eSpark-Backup/jordanfishman-telephonecircuit/Design-Files/TelephoneCircuit-v1.0/Deliverables/Renderings/2D-C-View.png

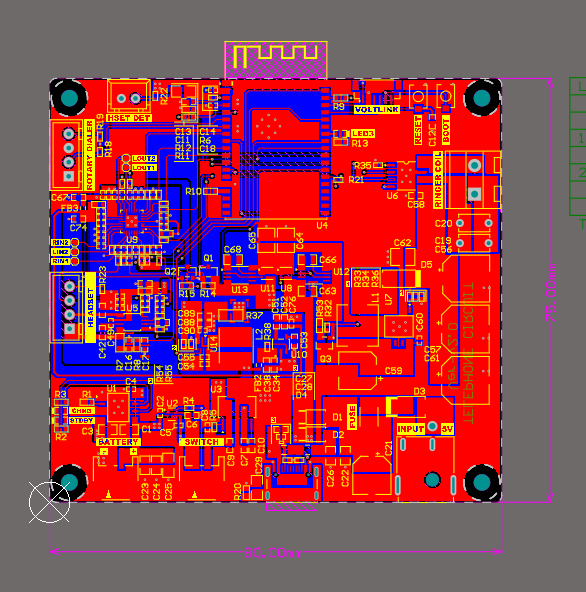
Design-Files/TelephoneCircuit-v1.0/Deliverables/Renderings/2D-C-View.png
