eSpark-Backup/jordanfishman-telephonecircuit/Design-Files/TelephoneCircuit-v1.0/Deliverables/Renderings/2D-TOP-View.png

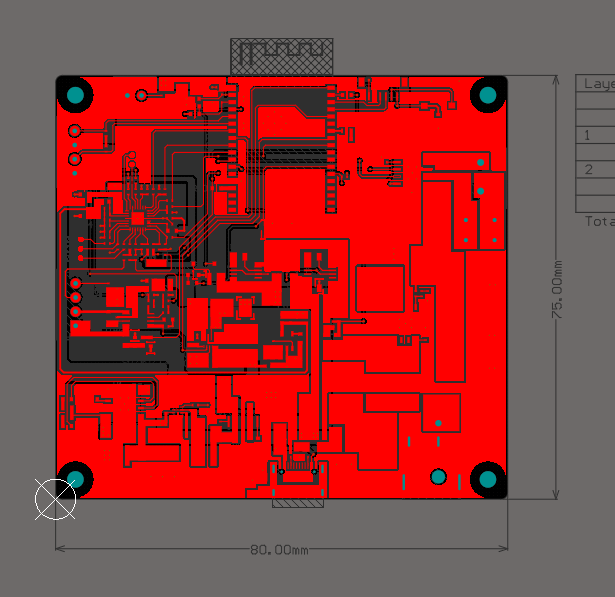
Design-Files/TelephoneCircuit-v1.0/Deliverables/Renderings/2D-TOP-View.png
