eSpark-Backup/jordanfishman-telephonecircuit/Design-Files/TelephoneCircuit-v1.0/Deliverables/Renderings/3D-BottomSide.png

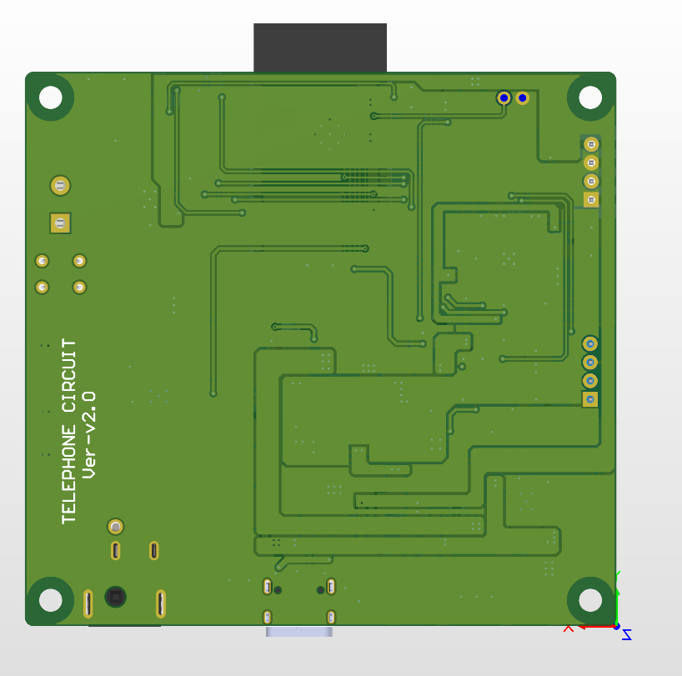
Design-Files/TelephoneCircuit-v1.0/Deliverables/Renderings/3D-BottomSide.png
