eSpark-Backup/jordanfishman-telephonecircuit/Design-Files/TelephoneCircuit-v1.0/Deliverables/Renderings/3D-TopSide.png

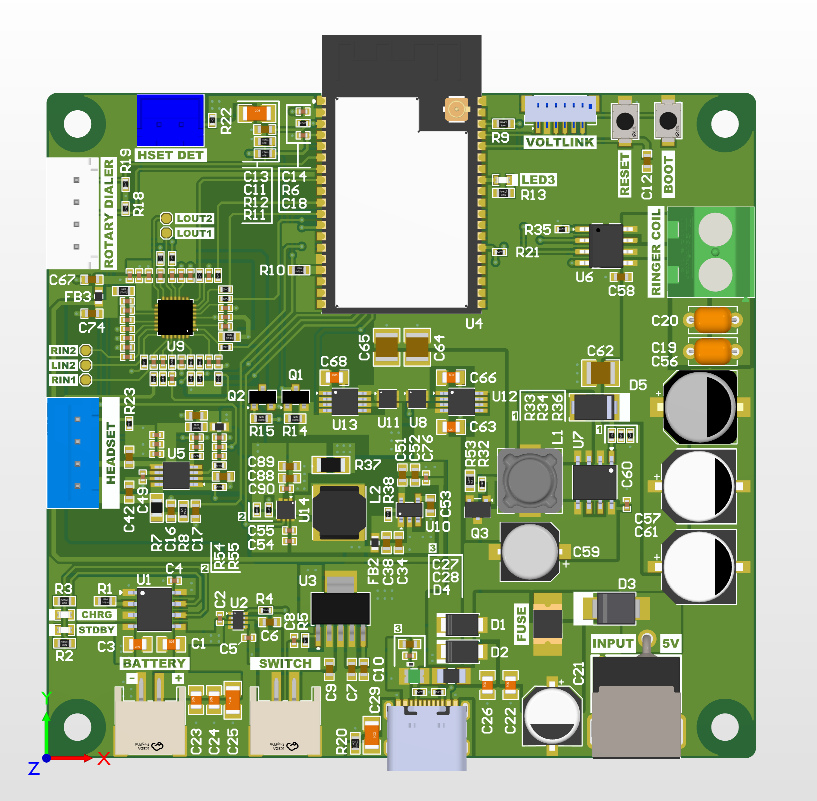
Design-Files/TelephoneCircuit-v1.0/Deliverables/Renderings/3D-TopSide.png
