eSpark-Backup/jordanfishman-telephonecircuit/Design-Files/TelephoneCircuit-v1.0/Deliverables/Renderings/Isometric.png

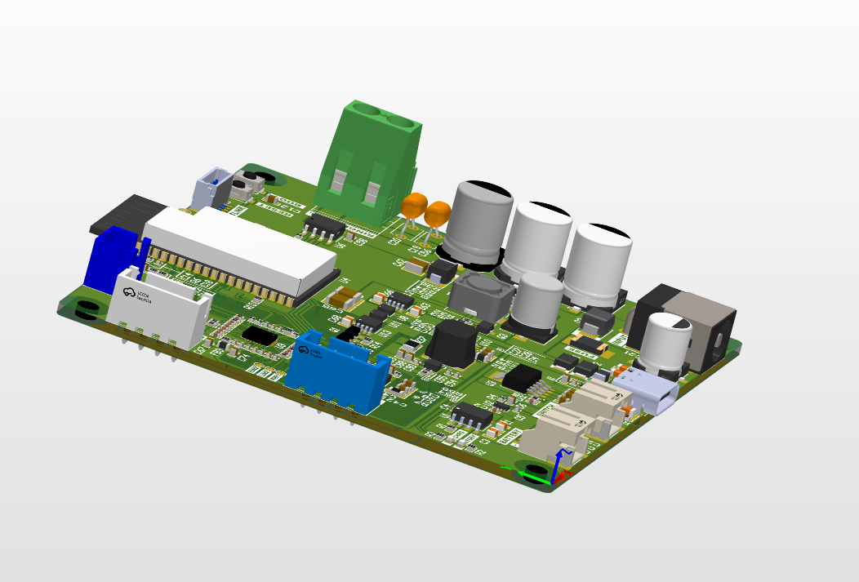
Design-Files/TelephoneCircuit-v1.0/Deliverables/Renderings/Isometric.png
