eSpark-Backup/jordanfishman-telephonecircuit/Design-Files/TelephoneCircuit-v1.0/Deliverables/BOM/Client-BOM-V1.0.xlsx

# | Item Type | Designator | Description | Footprint | Manufacturer Part Number | Manufacturer | Value | Quantity | Remarks
1 | Capacitor | C1, C3, C23, C24, C26 | CAP CER 10UF 25V X5R 0805 | Cap-0805 | CC0805KKX5R8BB106 | Yageo | 10uF | 5
2 | Capacitor | C2, C4, C5, C18, C30, C41, C44, C47, C55, C69, C70, C72, C75, C76, C83, C85, C87, C90 | CAP CER 0.1UF 25V X5R 0402 | Cap-0402 | CC0402KRX5R8BB104 | Yageo | 100nF | 18
3 | Capacitor | C6, C15, C50 | CAP CER 1UF 25V X5R 0603 | Cap-0603 | CC0603KRX5R8BB105 | Yageo | 1uF | 3
4 | Capacitor | C7, C88, C89 | CAP CER 22UF 10V X5R 0603 | Cap-0603 | CC0603MRX5R6BB226 | Yageo | 22uF | 3
5 | Capacitor | C8 | CAP CER 2.2UF 25V X5R 0402 | Cap-0402 | GRM155R61E225KE11D | Murata | 2.2uF | 1
6 | Capacitor | C9, C74 | CAP CER 10UF 16V X5R 0603 | Cap-0603 | CC0603KRX5R7BB106 | Yageo | 10uF | 2
7 | Capacitor | C10, C27 | CAP CER 10000PF 50V C0G/NPO 0603 | Cap-0603 | CC0603JRNPO9BN103 | Yageo | 10nF | 2
8 | Capacitor | C11 | CAP CER 1UF 50V X5R 0603 | Cap-0603 | CL10A105KB8NNNC | Samsung | 1uF | 1
9 | Capacitor | C12 | CAP CER 0.1UF 50V X5R 0603 | Cap-0603 | CC0603KRX5R9BB104 | Yageo | 100nF | 1
10 | Capacitors | C13, C25 | 10V 100uF X5R ±20% 1206 Multilayer Ceramic Capacitors MLCC - SMD/SMT ROHS | Cap-1206 | GRM31CR61A107ME05L | Murata | 100uF | 2
11 | Capacitors | C14 | CAP CER 0.1UF 16V X5R 0402 | Cap-0402 | CC0402KRX5R7BB104 | Yageo | 100nF | 1
12 | Capacitor | C16, C17 | 25V 100nF X7R ±10% 0603 Multilayer Ceramic Capacitors MLCC - SMD/SMT ROHS | Cap-0603 | CL10B104KA8NNNC | Samsung Electro-Mechanics | 100nF | 2
13 | Capacitor | C19 | 10% 100V 2.2uF X7R Plugin,P=5.08mm Multilayer Ceramic Capacitors MLCC - Leaded ROHS | Custom | CD2A225KC9BER1F100 | Dersonic | 2.2uF | 1
14 | Capacitor | C20 | 10% 250V 1uF X7R Plugin,P=5.08mm Multilayer Ceramic Capacitors MLCC - Leaded ROHS | Custom | CD2E105KC1IER1I100 | Dersonic | 1uF | 1
15 | Capacitors | C21 | 220uF 35V 600mA@100KHz 160mΩ@100KHz ±20% SMD,D6.3xL7.7mm Aluminum Electrolytic Capacitors - SMD ROHS | Custom | 189RV0019 | KNSCHA | 220uF | 1
16 | Capacitors | C22 | CAP CER 1UF 100V X7S 0805 | Cap-0805 | GCM21BC72A105KE36L | Murata | 1uF | 1
17 | Capacitor | C28 | CAP CER 1UF 16V X5R 0402 | Cap-0402 | CC0402KRX5R7BB105 | Yageo | 1uF | 1
18 | Capacitor | C29 | CAP CER 4700PF 1KV X7R 1206 | Cap-1206 | CC1206KKX7RCBB472 | Yageo | 4.7nF | 1
19 | Capacitor | C31, C32, C46 | CAP CER 22UF 10V X5R 0402 | Cap-0402 | GRM158R61A226ME15D | Murata | 22uF | 3
20 | Capacitor | C33, C35, C54, C71, C73, C82, C84, C86 | CAP CER 10UF 10V X5R 0402 | Cap-0402 | CL05A106MP5NUNC | Samsung | 10uF | 8
21 | Capacitor | C34, C51 | CS Series 0603 0.1 uF 25 V ±10% X7R Multilayer Ceramic Capacitor | Cap-0603 | CS0603KRX7R8BB104 | Yageo | 0.1uF | 2
22 | Capacitor | C36, C37, C39, C40, C49 | CAP CER 1UF 16V X5R 0402 | Cap-0402 | CL05A105KO5NNNC | Samsung | 1uF | 5
23 | Capacitor | C38, C52 | CAP CER 10UF 25V X5R 0603 | Cap-0603 | CL10A106MA8NRNC | Samsung | 10uF | 2
24 | Capacitor | C42, C43 | CAP CER 330PF 50V C0G/NPO 0603 | Cap-0603 | CC0603JRNPO9BN331 | Yageo | 330pF | 2
25 | Capacitor | C45, C48 | CAP CER 39PF 50V C0G/NPO 0402 | Cap-0402 | CC0402FRNPO9BN390 | Yageo | 39pF | 2
26 | Capacitor | C53 | 25V 22nF X7R 0603 Multilayer Ceramic Capacitors MLCC - SMD/SMT ROHS | Cap-0603 | FN18X223K250PSG | PSA(Prosperity Dielectrics) | 22nF | 1
27 | Capacitor | C56 | CAP ALUM 47UF 20% 80V SMD | Custom | EEE-FN1K470UP | Panasonic | 47uF | 1
28 | Capacitor | C57, C61 | 100uF 80V 735mA@100kHz ±20% SMD,D8xL14.5mm Aluminum Electrolytic Capacitors - SMD ROHS | Custom | VKMD1451K101MV | Ymin | 100uF | 2
29 | Capacitor | C58 | CAP CER 0.1UF 50V Y5V 0603 | Cap-0603 | CC0603ZRY5V9BB104 | Yageo | 0.1uF | 1
30 | Capacitor | C59 | 330uF 16V ±20% SMD,D6.3xL7.7mm Aluminum Electrolytic Capacitors - SMD ROHS | Custom | GVT1C331M0607 | Honor Elec | 330uF | 1
31 | Capacitor | C60 | CAP CER 4.7UF 10V X5R 0402 | Cap-0402 | CC0402KRX5R6BB475 | Yageo | 4.7uF | 1
32 | Capacitor | C62, C64, C65 | CAP CER 10UF 63V X7R 1210 | Cap-1210 | GRM32ER71J106KA12L | Murata | 10uF | 3
33 | Capacitor | C63 | CAP CER 100PF 50V X7R 0805 | Cap-0805 | CC0805KRX7R9BB101 | Yageo | 100pF | 1
34 | Capacitor | C66, C68 | CAP CER 2.2UF 50V X5R 0805 | Cap-0805 | C2012X5R1H225K125AB | TDK | 2.2uF | 2
35 | Capacitor | C67 | CAP CER 4.7UF 16V X5R 0603 | Cap-0603 | CC0603KRX5R7BB475 | Yageo | 4.7uF | 1
36 | Capacitor | C77, C78, C79, C80, C81 | CAP CER 20PF 50V C0G/NPO 0402 | Cap-0402 | CC0402JRNPO9BN200 | Yageo | 20pF | 5
37 | Diodes | D1, D2 | DIODE SCHOTTKY 30V 3A SOD128 | SOD-128 | PMEG3030EP,115 | Nexperia | - | 2
38 | Diode | D3 | SCHOTTKY DIODE SMB 100V 5A | SMB_ | SS510B | MDD | - | 1
39 | Diode | D4 | TVS DIODE 5VWM 6.3VC DSN0603-2 | DSN0603-2 | PESD5V0H1BSFYL | Nexperia | - | 1
40 | Diode | D5 | 60V 700mV@2A 2A SMA(DO-214AC) Schottky Barrier Diodes (SBD) ROHS | SMA(DO-214AC) | SS26 | MDD | - | 1
41 | Fuse | F1 | 13.2V 2.6A 40A 800mW -40℃~+85℃ 5.2A 10mΩ 2.5s 50mΩ 1812 Resettable Fuses ROHS | 1812-FUSE | BSMD1812-260-13.2V | BHFUSE | - | 1
42 | Fuse | F2 | 6V 2A 50A 1W -40℃~+85℃ 4A 4mΩ 5s 45mΩ 0805 Resettable Fuses ROHS | Fuse-0805 | BSMD0805L-200 | BHFUSE | - | 1
43 | Ferrite Bead | FB1 | FERRITE BEAD 120 OHM 1206 1LN | IND-1206 | BLM31PG121SN1L | Murata | 100MHz | 1
44 | Ferrite Bead | FB2, FB3 | FERRITE BEAD 120 OHM 0603 1LN | IND-0603 (1608 Metric) | BLM18SG121TN1D | Murata | - | 2
45 | Ferrite Bead | FB4 | 0603 180Ω ±25% DCR=0.09Ω 1.5A | IND-0603 (1608 Metric) | BLM18PG181SN1D | Murata | - | 1
46 | Connectors | J1, J3 | CONN HEADER SMD R/A 2POS 2MM | Custom | S2B-PH-SM4-TB(LF)(SN) | JST | - | 2
47 | Connector | J2 | 1x6P SH 1 1mm 6 SMD,P=1mm Wire To Board / Wire To Wire Connector ROHS | Custom | C145963 | BOOMELE | - | 1
48 | DC Power Connectors | J4 | Bend insert DC Power Receptacle -30℃~+85℃ 2.5mm 6mm 7A 24V Plugin DC Power Connectors ROHS | Custom | DC-044K-D025 | G-Switch | - | 1
49 | Terminal Blocks | J5 | TERM BLK 2P SIDE ENT 5.08MM PCB | Custom | 1715721 | Phoenix Contact | - | 1
50 | USB Connector | J6 | 5A 1 16P Female Type-C SMD USB Connectors ROHS | Custom | TYPE-C-31-M-12 | Korean Hroparts Elec | - | 1
51 | Wire To Board Connector | J7 | 1x4P 4P XH 1 Tin 2.5mm 4 -25℃~+85℃ Brass 3A Straight Plugin,P=2.5mm Wire To Board Connector ROHS | Custom | XH-4A | HCTL | - | 1
52 | Wire To Board Connector | J8 | 1x2P 2P XH 1 Tin 2.5mm 2 -25℃~+85℃ Brass 3A Straight Plugin,P=2.5mm Wire To Board Connector ROHS | Custom | XH-2A-L | HCTL | - | 1
53 | Wire To Board Connector | J9 | 1x4P 4P XH 1 Tin 2.5mm 4 -25℃~+85℃ Brass 3A Straight Plugin,P=2.5mm Wire To Board Connector ROHS | Custom | XH-4A-L | HCTL | - | 1
54 | Inductor | L1 | 3.7A 4.7uH ±20% SMD,7.3x7.3mm Power Inductors ROHS | Custom | YPRH0704-4R7M | YJYCOIN | 4.7uH | 1
55 | INductor | L2 | 5.15A 1uH ±30% SMD Power Inductors ROHS | Custom | MPIT6045-1R0N-LF | microgate | 1uH | 1
56 | LED | LED1, LED3 | RED LED 0603 Light Emitting Diodes | LED-0603 | NCD0603R3 | Foshan NationStar Optoelectronics | - | 2
57 | LED | LED2 | Emerald 0603 Light Emitting Diodes (LED) ROHS | LED-0603 | NCD0603G2 | Foshan NationStar Optoelectronics | - | 1
58 | Mosfet | Q1 | 30V 4.1A 60mΩ@10V,4.1A 350mW 3V@250uA P Channel SOT-23 MOSFETs ROHS | SOT-23 | AO3407 | Guangdong Hottech | - | 1
59 | Mosfet | Q2 | TRANS NPN 40V 0.6A SMD SOT23-3 | SOT-23 | MMBT2222A-7-F | Diodes | - | 1
60 | MOSFETs | Q3 | MOSFET P-CH 20V 6A SOT23F | SOT-23F | SSM3J328R,LF | Toshiba | - | 1
61 | Resistor | R1 | Thick Film Resistors 75V 1.2kΩ 0603 Chip Resistor - Surface Mount ROHS | Res-0603 | 0603WAF1201T5E | UNI-ROYAL | 1.2K | 1
62 | Resistor | R2, R3 | RES SMD 330R 100 mW 0603 | Res-0603 | RC0603JR-07330RL | Yageo | 330R | 2
63 | Resistor | R4, R5, R32, R45 | RES 10K OHM 1% 1/16W 0402 | Res-0402 | RC0402FR-0710KL | Yageo | 10K | 4
64 | Resistor | R6, R18, R19, R22, R51 | RES 10K OHM 1% 1/5W 0402 | Res-0402 | SR0402FR-7T10KL | Yageo | 10K | 5
65 | Resistor | R7 | RES 10K OHM 1% 1/4W 0805 | RES-0805 | RC0805FR-7W10KL | Yageo | 10K | 1
66 | Resistor | R8, R9, R10 | RES SMD 1K OHM 1% 1/10W 0603 | Res-0603 | CRCW06031K00FKEA | Vishay Dale | 1K | 3
67 | Resistor | R11 | RES SMD 100K OHM 0.1% 1/10W 0603 | Res-0603 | RT0603BRD07100KL | Yageo | 100K | 1
68 | Resistor | R12 | RES 270K OHM 0.5% 1/10W 0603 | Res-0603 | RC0603DR-07270KL | Yageo | 270K | 1
69 | Resistors | R13 | RES SMD 100 OHM 1% 1/10W 0603 | Res-0603 | CRCW0603100RFKEA | Vishay Dale | 100R | 1
70 | Resistor | R14, R15 | RES SMD 1K OHM 1% 1/10W 0603 | Res-0603 | RC0603FR-071KL | Yageo | 1K | 2
71 | Resistor | R16, R17 | RES 5.1K OHM 1% 1/16W 0402 | Res-0402 | RC0402FR-075K1L | Yageo | 5.1K | 2
72 | Resistor | R20 | RES SMD 1M OHM 1% 1/10W 0603 | Res-0603 | RC0603FR-071ML | Yageo | 1M | 1
73 | Resistor | R21, R23, R30 | RES SMD 0 OHM JUMPER 1/5W 0402 | Res-0402 | RCS04020000Z0ED | Vishay Dale | 0R | 3
74 | Resistor | R24, R25, R46, R47, R48, R49, R50 | RES 33 OHM 1% 1/16W 0402 | Res-0402 | RC0402FR-0733RL | Yageo | 33R | 7
75 | Resistor | R26 | RES SMD 10 OHM 1% 1/10W 0603 | Res-0603 | RC0603FR-0710RL | Yageo | 10R | 1
76 | Resistor | R27, R31 | RES SMD 30K OHM 1% 1/16W 0402 | Res-0402 | AC0402FR-0730KL | Yageo | 30K | 2
77 | Resistor | R28, R38 | RES 1K OHM 1% 1/16W 0402 | Res-0402 | RC0402FR-071KL | Yageo | 1K | 2
78 | Resistor | R29, R41, R43 | RES 2K OHM 1% 1/16W 0402 | Res-0402 | RC0402FR-072KL | Yageo | 2K | 3
79 | Resistor | R33 | RES SMD 240K OHM 1% 1/10W 0402 | Res-0402 | ERJ-2RKF2403X | Panasonic | 240K | 1
80 | Resistor | R34 | RES 6.2K OHM 1% 1/16W 0402 | Res-0402 | RC0402FR-076K2L | Yageo | 6.2K | 1
81 | Resistor | R35 | RES SMD 1.3K OHM 5% 1/10W 0402 | Res-0402 | ERJ-2GEJ132X | Panasonic | 1.3K | 1
82 | Resistor | R36 | 62.5mW Thick Film Resistors 50V ±100ppm/℃ ±0.5% 806Ω 0402 Chip Resistor - Surface Mount ROHS | Res-0402 | 0402WGD8060TCE | UNI-ROYAL | 806R | 1
83 | Resistor | R37 | RES SMD 0 OHM JUMPER 1/4W 1206 | Res-1206 | CRCW12060000Z0EA | Vishay | 0R | 1
84 | Resistor | R39 | RES SMD 47OHM 0.1W 0603 | Res-0603 | RC0603FR-0747RL | Yageo | 47R | 1
85 | Resistor | R40 | RES 4.7 OHM 1% 1/10W 0603 | Res-0603 | RC0603FR-074R7L | Yageo | 4.7R | 1
86 | Resistor | R42, R44 | RES 100 OHM 1% 1/16W 0402 | Res-0402 | RC0402FR-07100RL | Yageo | 100R | 2
87 | Resistor | R52, R55 | RES 100K OHM 1% 1/16W 0402 | Res-0402 | RC0402FR-07100KL | Yageo | 100K | 2
88 | Resistor | R53 | RES 0 OHM JUMPER 1/10W 0603 | Res-0603 | RC0603JR-070RL | Yageo | 0R | 1
89 | Resistor | R54 | 62.5mW Thick Film Resistors ±1% ±200ppm/℃ 732kΩ 0402 Chip Resistor - Surface Mount ROHS | Res-0402 | RC-02W7323FT | FH (Guangdong Fenghua Advanced Tech) | 732K | 1
90 | Tactile Switch | SW1, SW2 | Without bracket 50mA 4mm 100000 Times 12V 160gf 3mm 2mm Round Button Standing paste SPST SMD Tactile Switches ROHS | Custom | TS-1088-AR02016 | XUNPU | - | 2
91 | IC | U1 | ESOP-8 Battery Management ICs ROHS | ESOP-8 | TP4056-42-ESOP8 | TOPPOWER | - | 1
92 | IC | U2 | OR Controller N+1 ORing Controller N-Channel 2:1 SOT-583 | SOT-583 | LM66200DRLR | Texas Instruments | - | 1
93 | IC | U3 | IC REG LINEAR 3.3V 1A SOT223-6 | SOT-223-6_ | TPS79633DCQR | Texas Instruments | - | 1
94 | Module | U4 | RF TXRX MODULE BT PCB TRACE SMD | Custom | ESP32-WROVER-E-N16R8 | Espressif Systems | - | 1
95 | IC | U5 | 3Wx1@4Ω Class D MSOP-8 Audio Power OpAmps ROHS | 8-MSOP (0.118", 3.00mm Width) | NS4150B | Shenzhen Nsiway Tech | - | 1
96 | IC | U6 | 48-V, 3.5-A H BRIDGE MOTOR DRIVE | SOPowerPAD(DDA)-8 | DRV8251ADDAR | Texas Instruments | - | 1
97 | IC | U7 | Boost type Adjustable 500mA 3V~60V 3V~60V ESOP-8 DC-DC Converters ROHS | ESOP-8 | LGS6302EP | Legend-Si | - | 1
98 | IC | U8, U11 | 30V 5A 2.3W 30mΩ@4A,8V null WSON-6 MOSFETs ROHS | Custom | CSD17313Q2 | Texas Instruments | - | 2
99 | IC | U9 | QFN-28-EP(4x4) ADCs/DACs - Special Purpose ROHS | QFN-28-EP(4x4) | ES8388 | Everest-semi | - | 1
100 |  | U10 | IC REG LDO 3.3V 0.3A SOT23-5 | SOT-23-5 | RT9193-33GB | Richtek | - | 1
101 | IC | U12, U13 | IC SMART DIODE CTLR 8VSSOP | 8-VSSOP (5x3.1mm) | LM74610QDGKRQ1 | Texas Instruments | - | 2
102 | IC | U14 | 8-A boost converter with 0.5-V ultra-low input voltage 7-VQFN-HR -40 to 125 | 7-VQFN-HR (2x2) | TPS61022RWUR | Texas Instruments | - | 1
103 | Peripheral | - | 16mm Flat Head Locking Panel Mount Push Button | - | 16mm Metal Button | - |  | 1 | Aliexpress (https://vi.aliexpress.com/item/1005005545806818.html?gatewayAdapt=glo2vnm)
104 | Peripheral | - | 20CM JST PH 2.0 2.0mm Pitch 2 Pin Male Female Cable Connector Micro JST PH 2P Plug Jack Socket Terminals Wire Cables Connectors | - | JST Cable | - | - | 1 | Aliexpress (https://vi.aliexpress.com/item/1005003235174686.html)
105 | Peripheral | - | 5V US 2Amp 5.5*2.5mm DC Power adapter | - | Adaptor | - | - | 1 | Aliexpress (https://vi.aliexpress.com/item/1005005815301733.html?scm_id=1007.40196.366991.0&scm-url=1007.40196.366991.0)
