eSpark-Backup/jordanfishman-telephonecircuit/Design-Files/TelephoneCircuit-v1.0/Deliverables/Supporting Files/Telephone Circuit v1.0.step

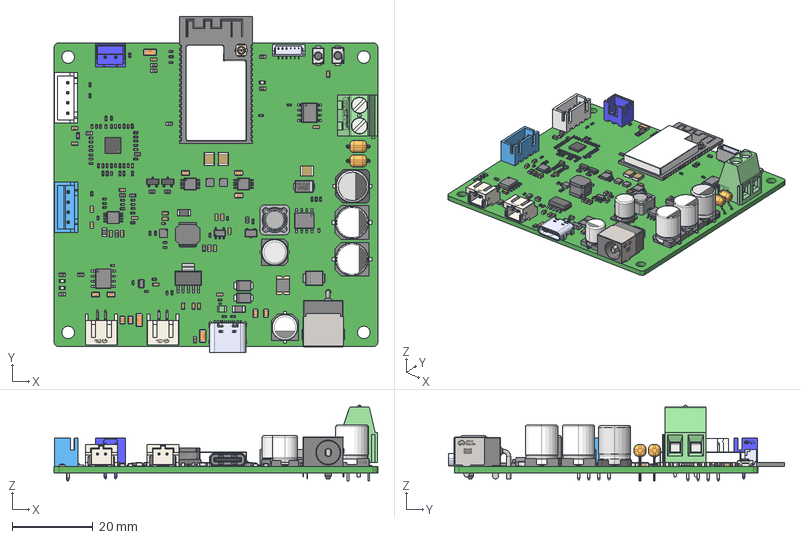
[picture p7: CAD file, 2025-02-03]
Design-Files/TelephoneCircuit-v1.0/Deliverables/Supporting Files/Telephone Circuit v1.0.step
80.0 x 83.0 x 18.7 mm
User Library-CAPC1608X09 x 23
TPS61022RWUR--3DModel-STEP-56544
LM74610QDGKRQ1 x 2
CSD17313Q2--3DModel-STEP-231308 x 2
SN74LV1T34DBVR
ES8374
TP4056-42-ESOP8--3DModel-STEP-56544 x 2
AD8223BRMZ-R7
ESP32-WROVER-I--3DModel-STEP-56544
User Library-SOT-223-6
User Library-RES_1005-0402 x 37
User Library-RESC1608X05N x 16
User Library-CR3216-1206
User Library-CR2012-0805
SSM3K333R_LF
CircuitWorks-SOT-23 x 2
User Library-LED SMD0603 x 3
MPIT6045-1R0N-LF
YPRH0704-4R7M
TYPE-C-31-M-12
SOLID.step.STEP.dwg.STEP.STEP.dwg
Lötende x 6
base x 3
BLM31PG121SN1L
User Library-fuse0805L050WR
MF-MSMF050
SMA (DO-214AC)
PESD5V0H1BSF
User Library-DO-214AA SMB
User Library-Capacitor 0402 x 45
User Library-0805 SMD Capacitor x 9
User Library-CAPC3225X10 x 3
VKMD1451K101MV x 2
GVT1C331M0607
User Library-1206 SMD Capacitor x 3
