eSpark-Backup/jordanfishman-telephonecircuit/(list of files, cad)

Other CAD files:
Design-Files/TelephoneCircuit-v1.0/Deliverables/Supporting Files/Telephone Circuit v1.0.DWG
Design-Files/TelephoneCircuit-v1.0/Deliverables/Supporting Files/Telephone Circuit v1.0.DXF
