eSpark-Backup/jordanfishman-telephonecircuit/Design-Files/TelephoneCircuit-v1.0/Schematic/Telephone Circuit V1.0.pdf

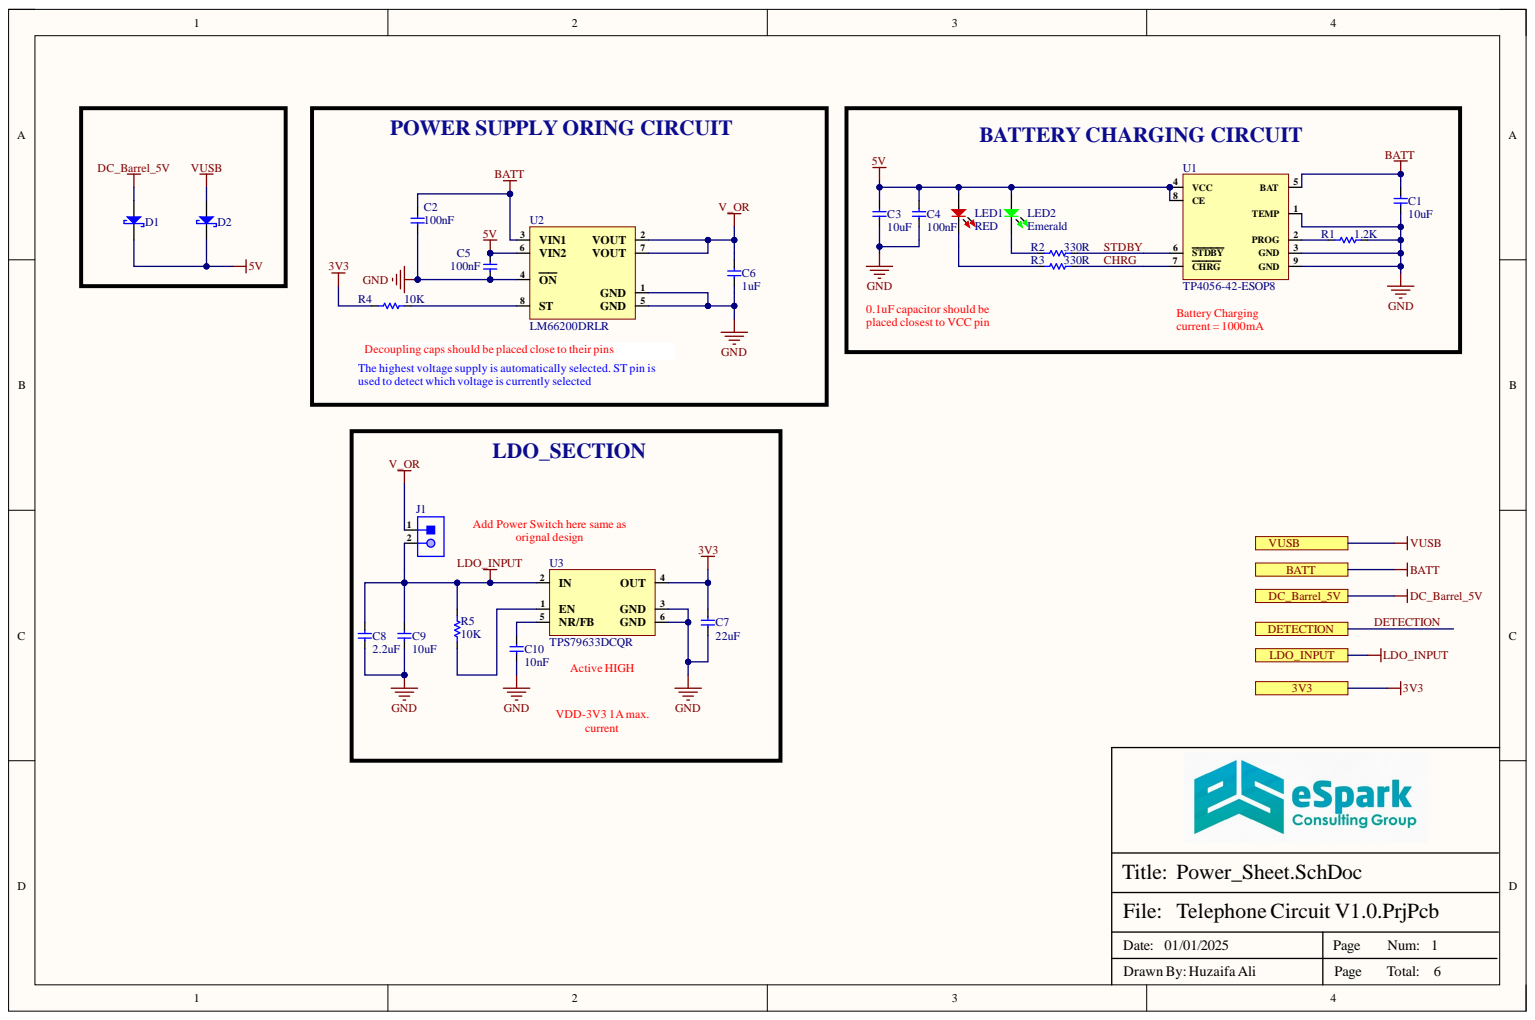
[picture p8: page 1]

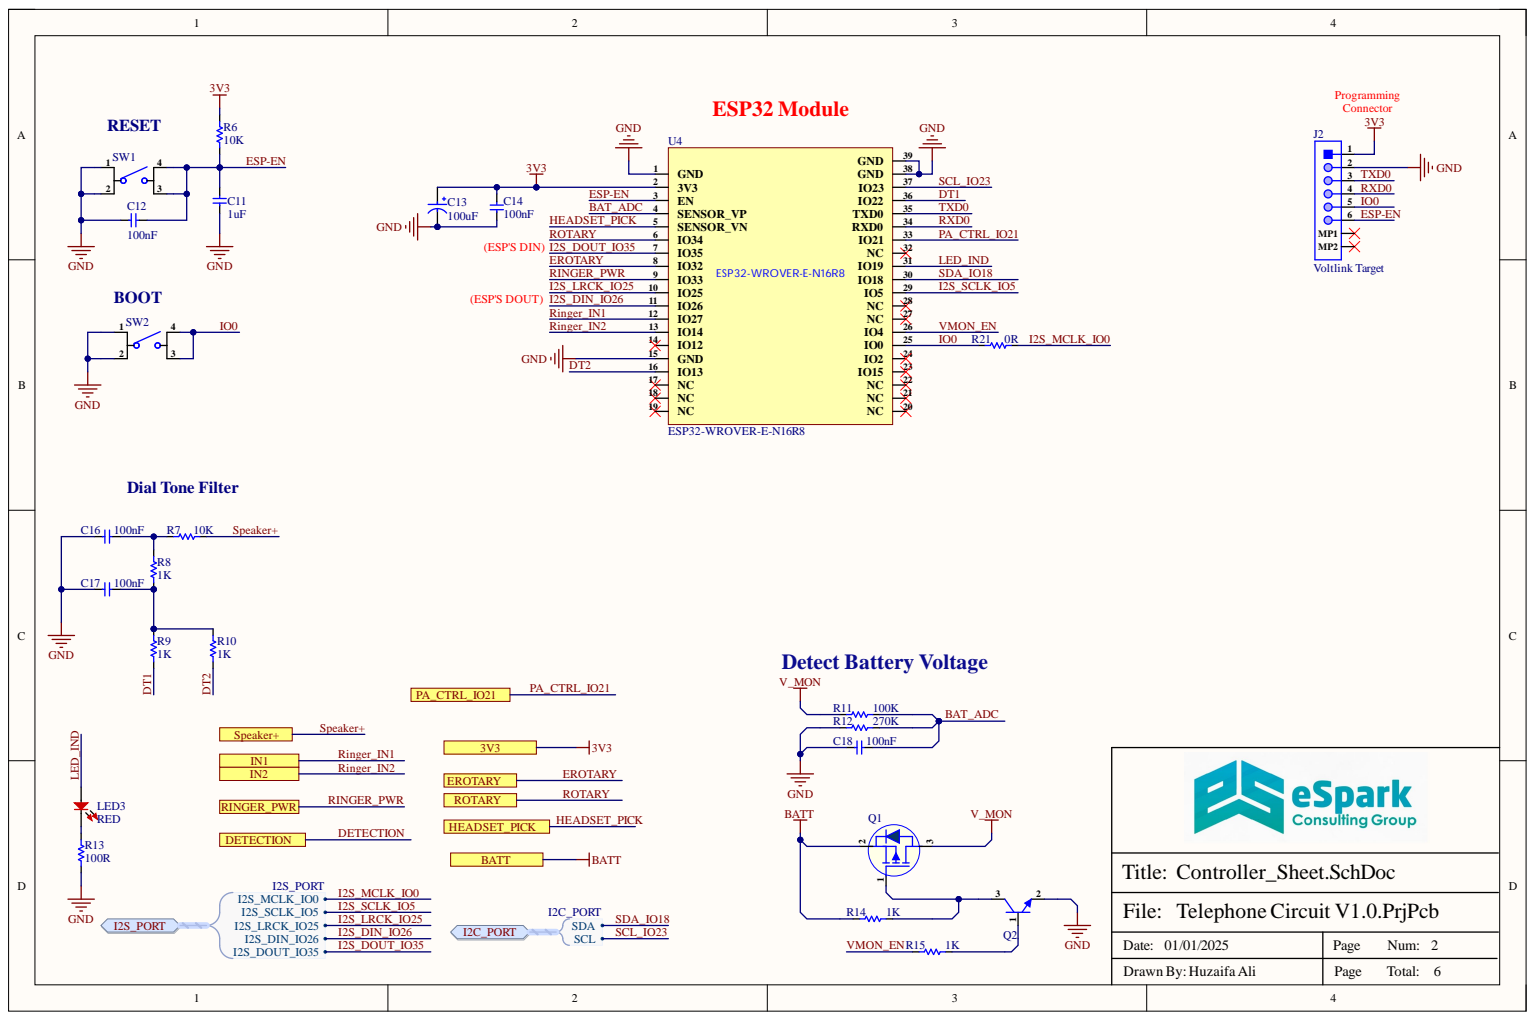
[picture p9: page 2]

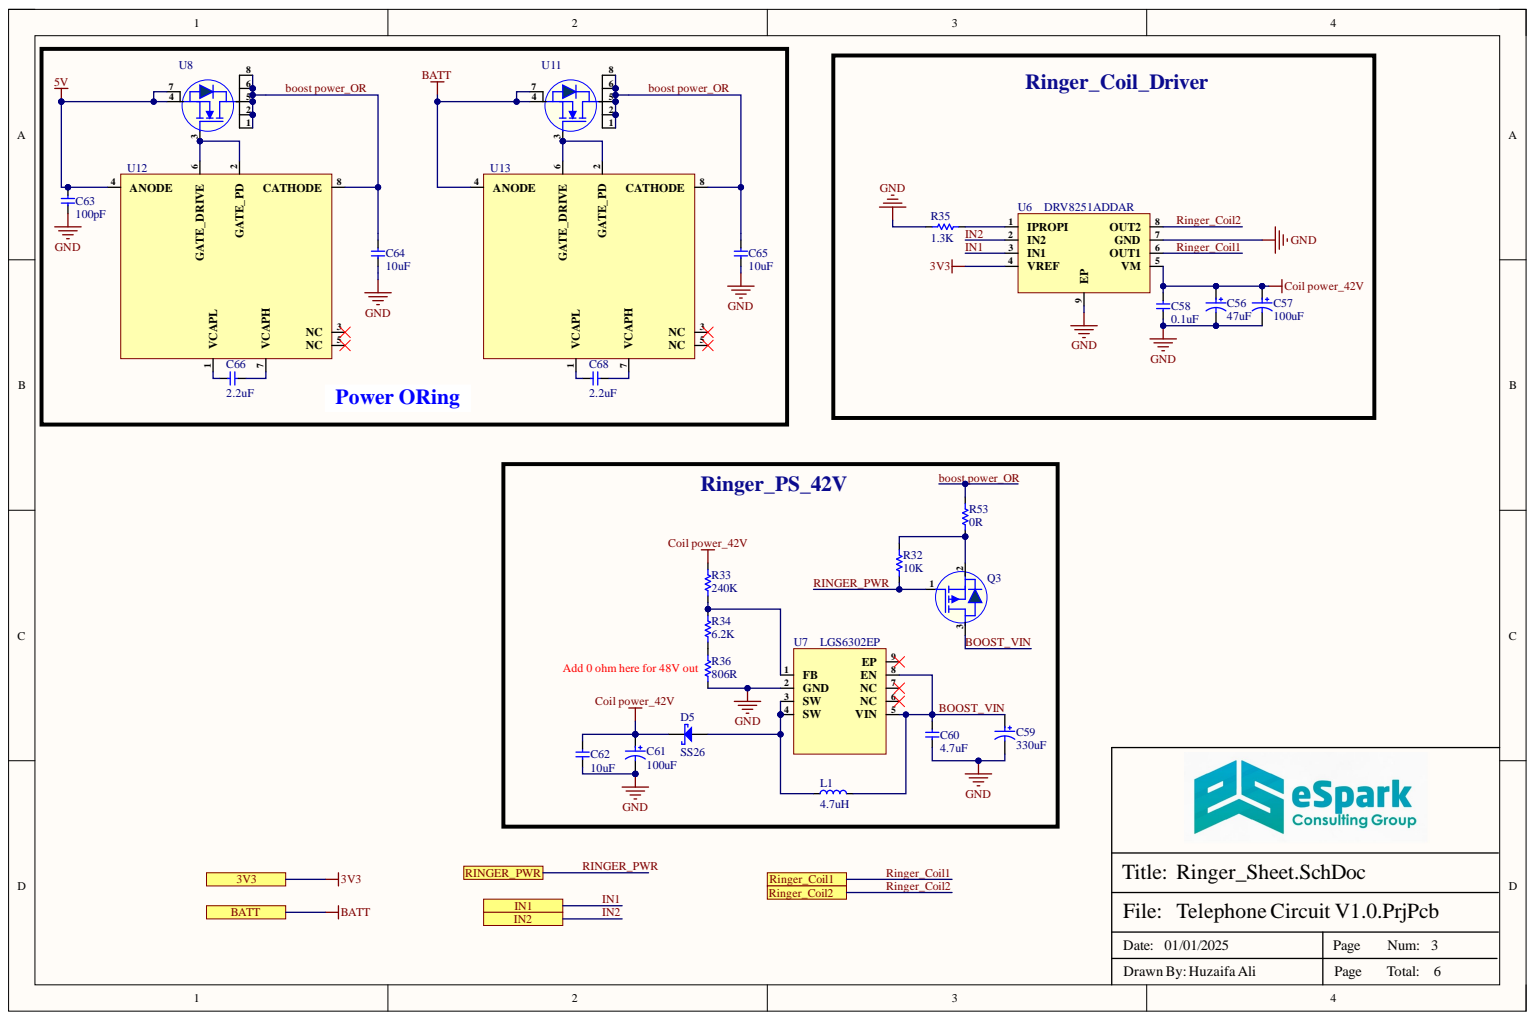
[picture p10: page 3]

806R Add 0 ohm here for 48V out

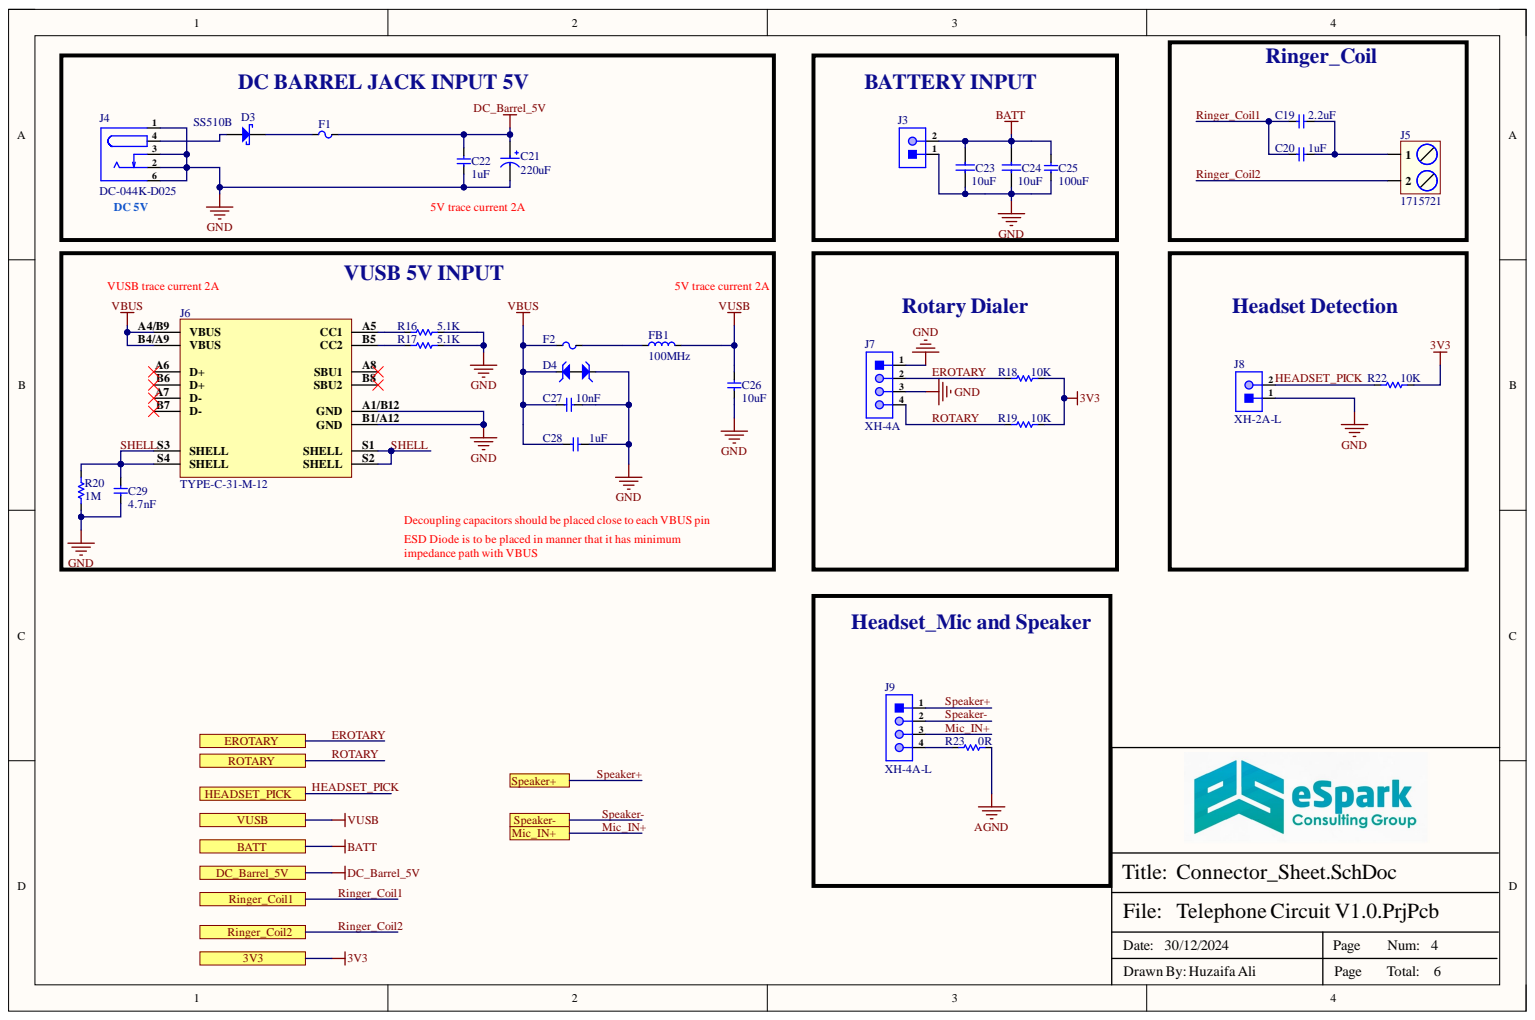
[picture p11: page 4]

DC BARREL JACK INPUT 5V

Decoupling capacitorsshould be placed close to each VBUS pin
ESD Diode is to be placed in manner that it has minimum
impedance path with VBUS

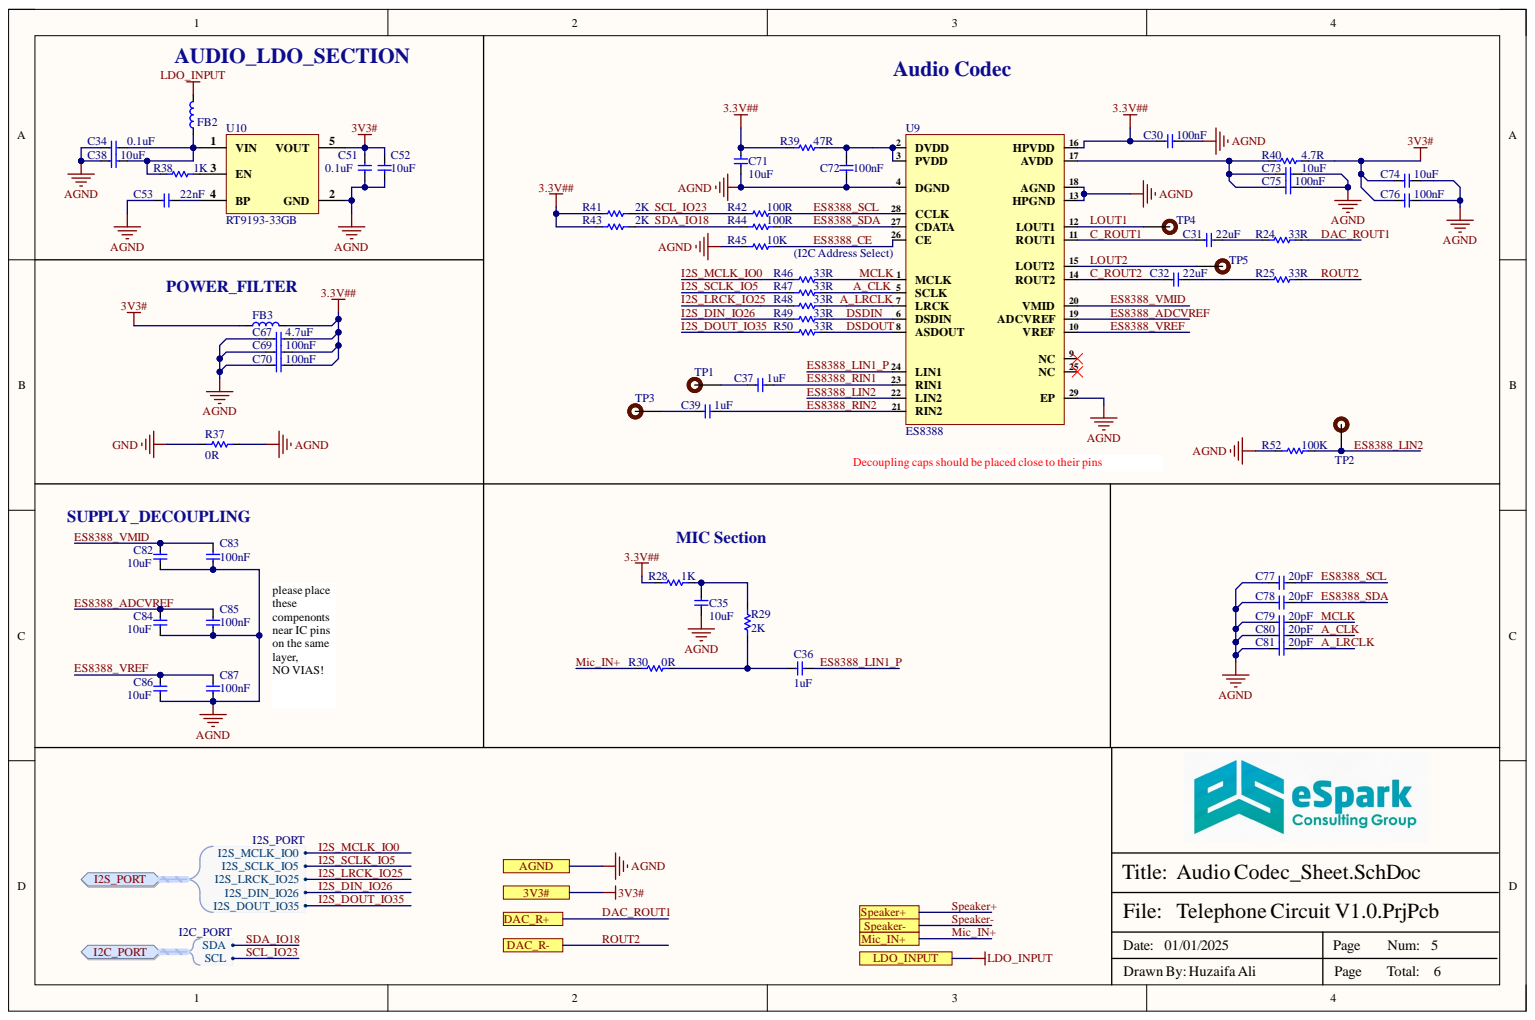
[picture p12: page 5]

Decoupling caps should be placed close to their pins

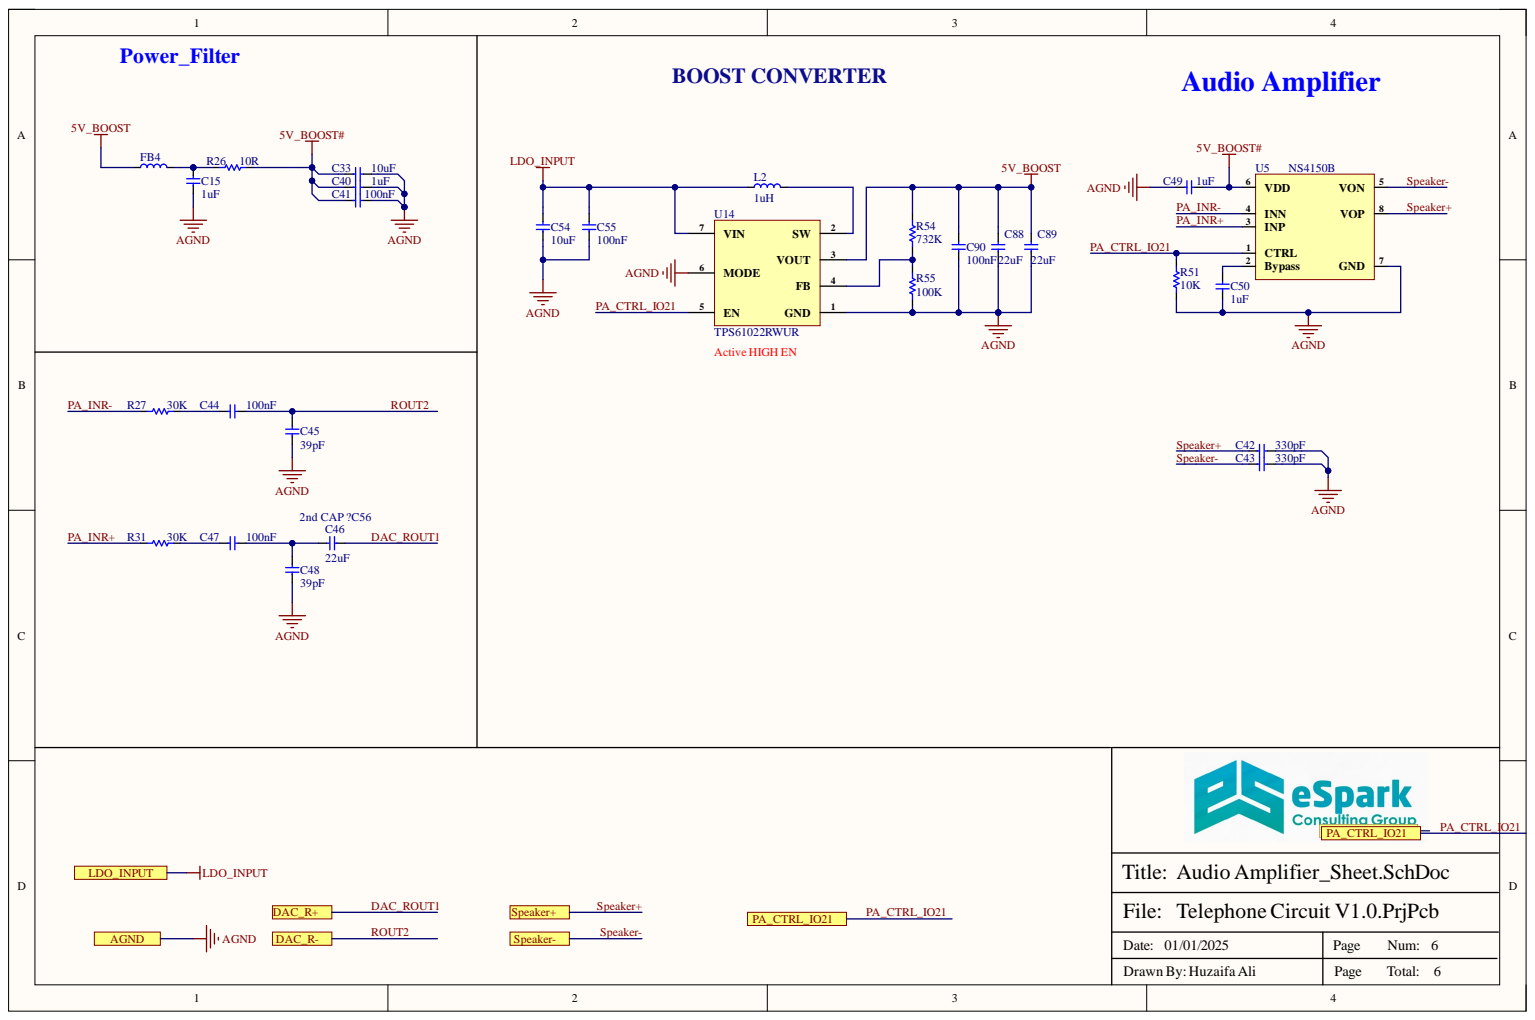
[picture p13: page 6]
