eSpark-Backup/jordanfishman-telephonecircuit/Design-Files/TelephoneCircuit-v1.0/Deliverables/Assembly Drawings/Telephone Circuit V1.0.pdf

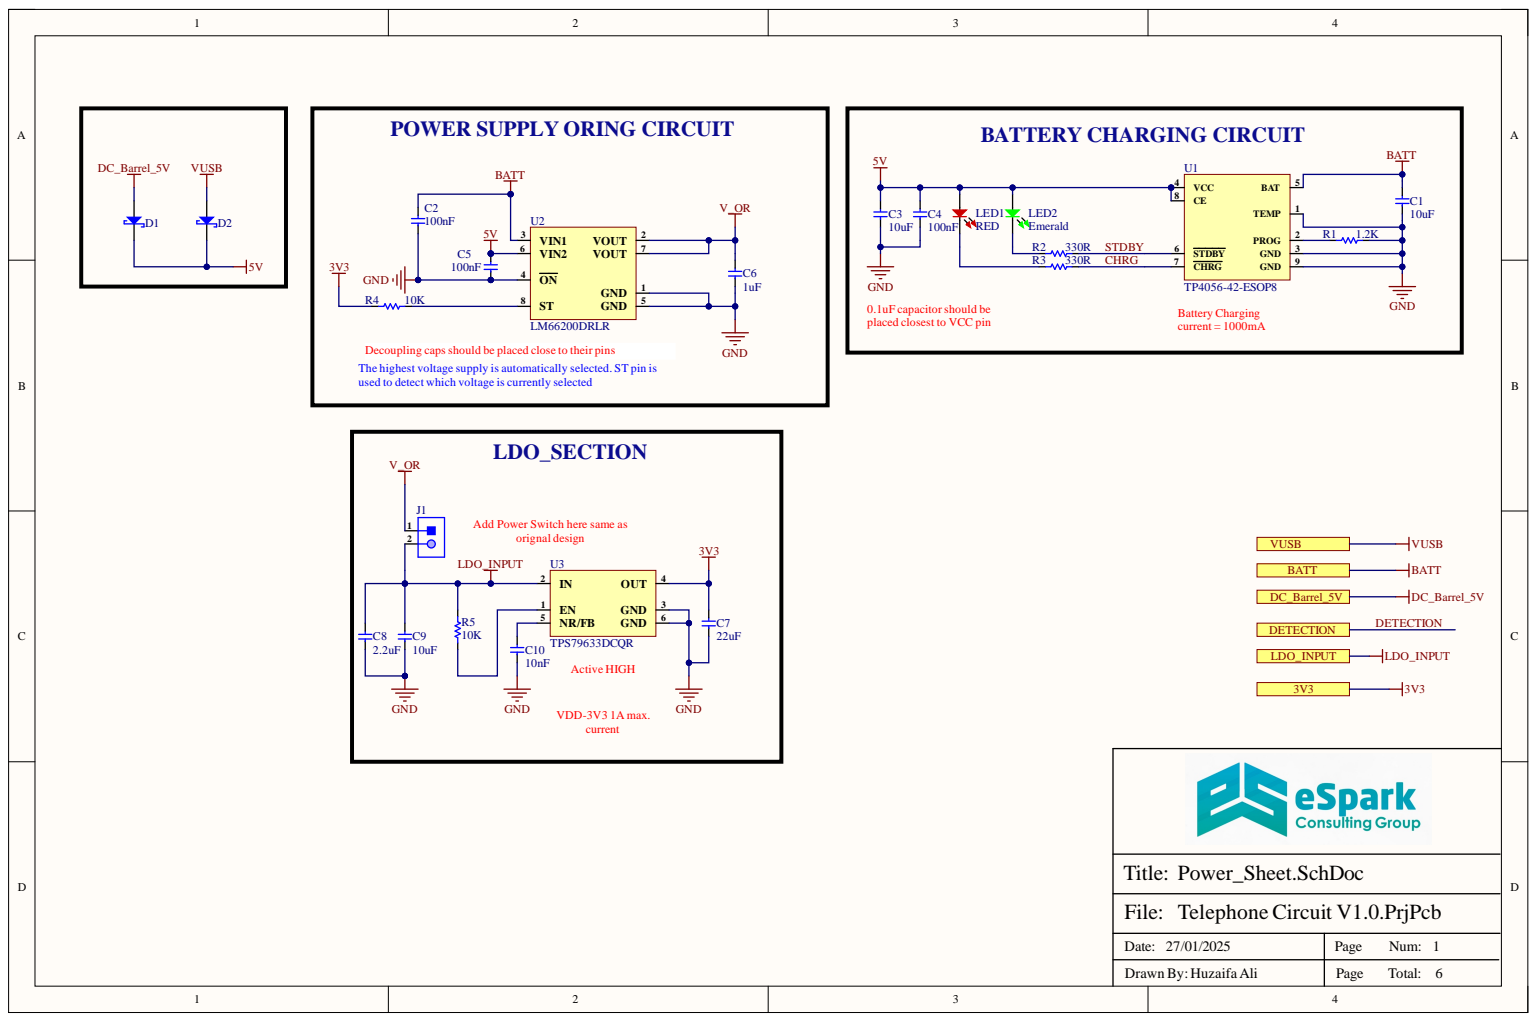
[picture p14: page 1]

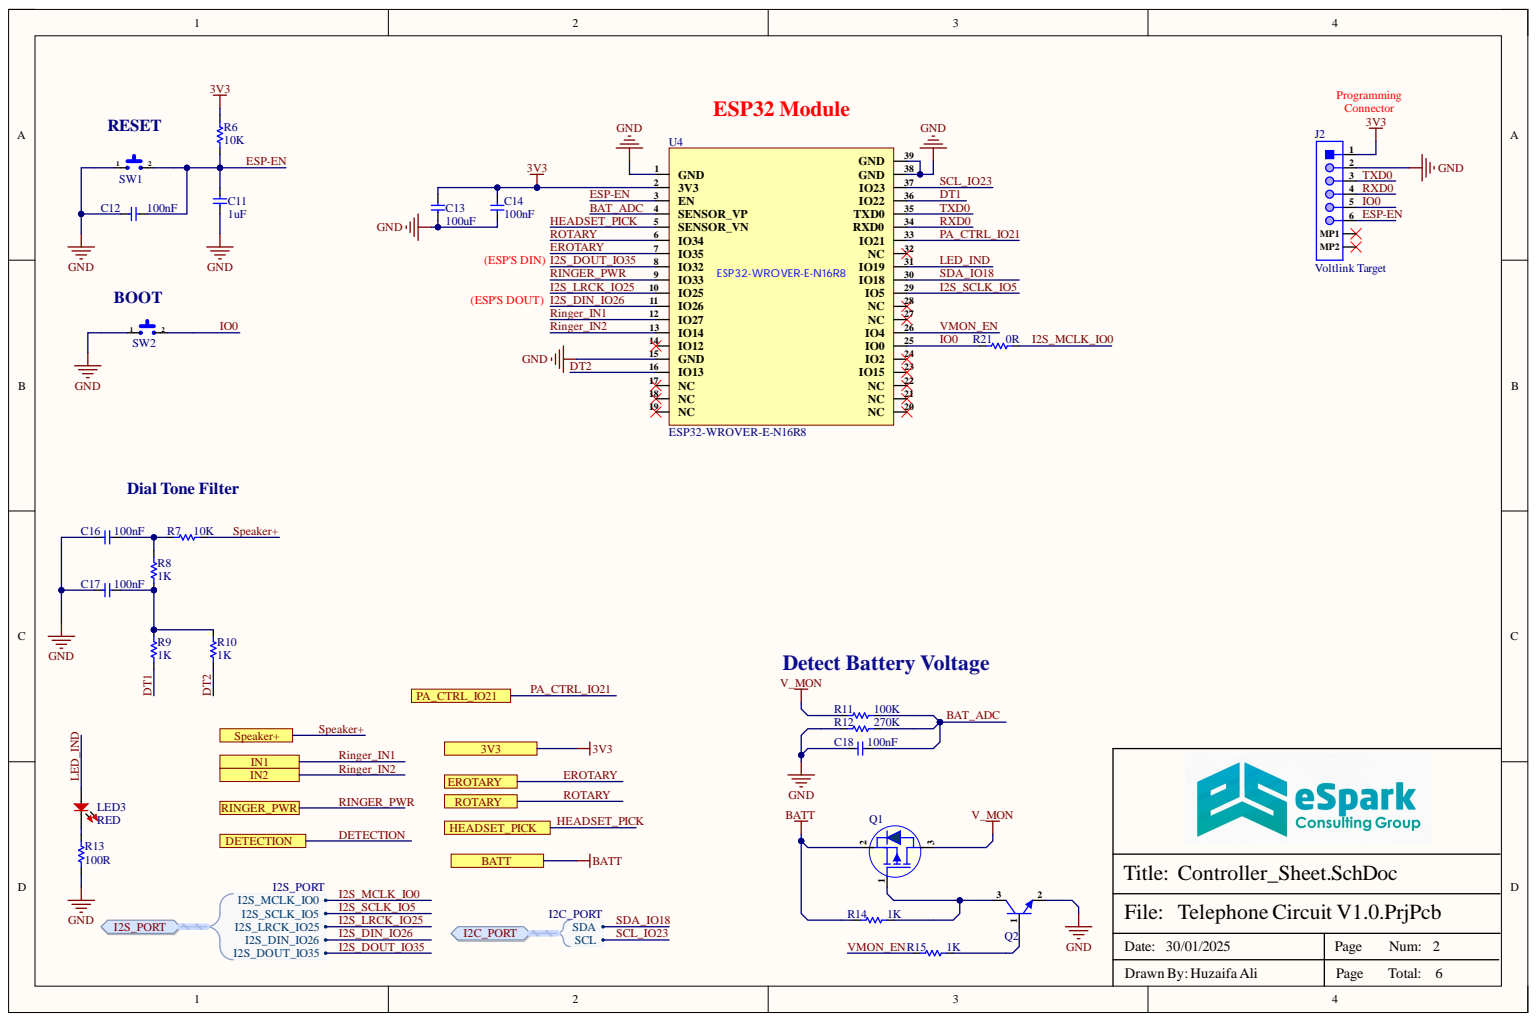
[picture p15: page 2]

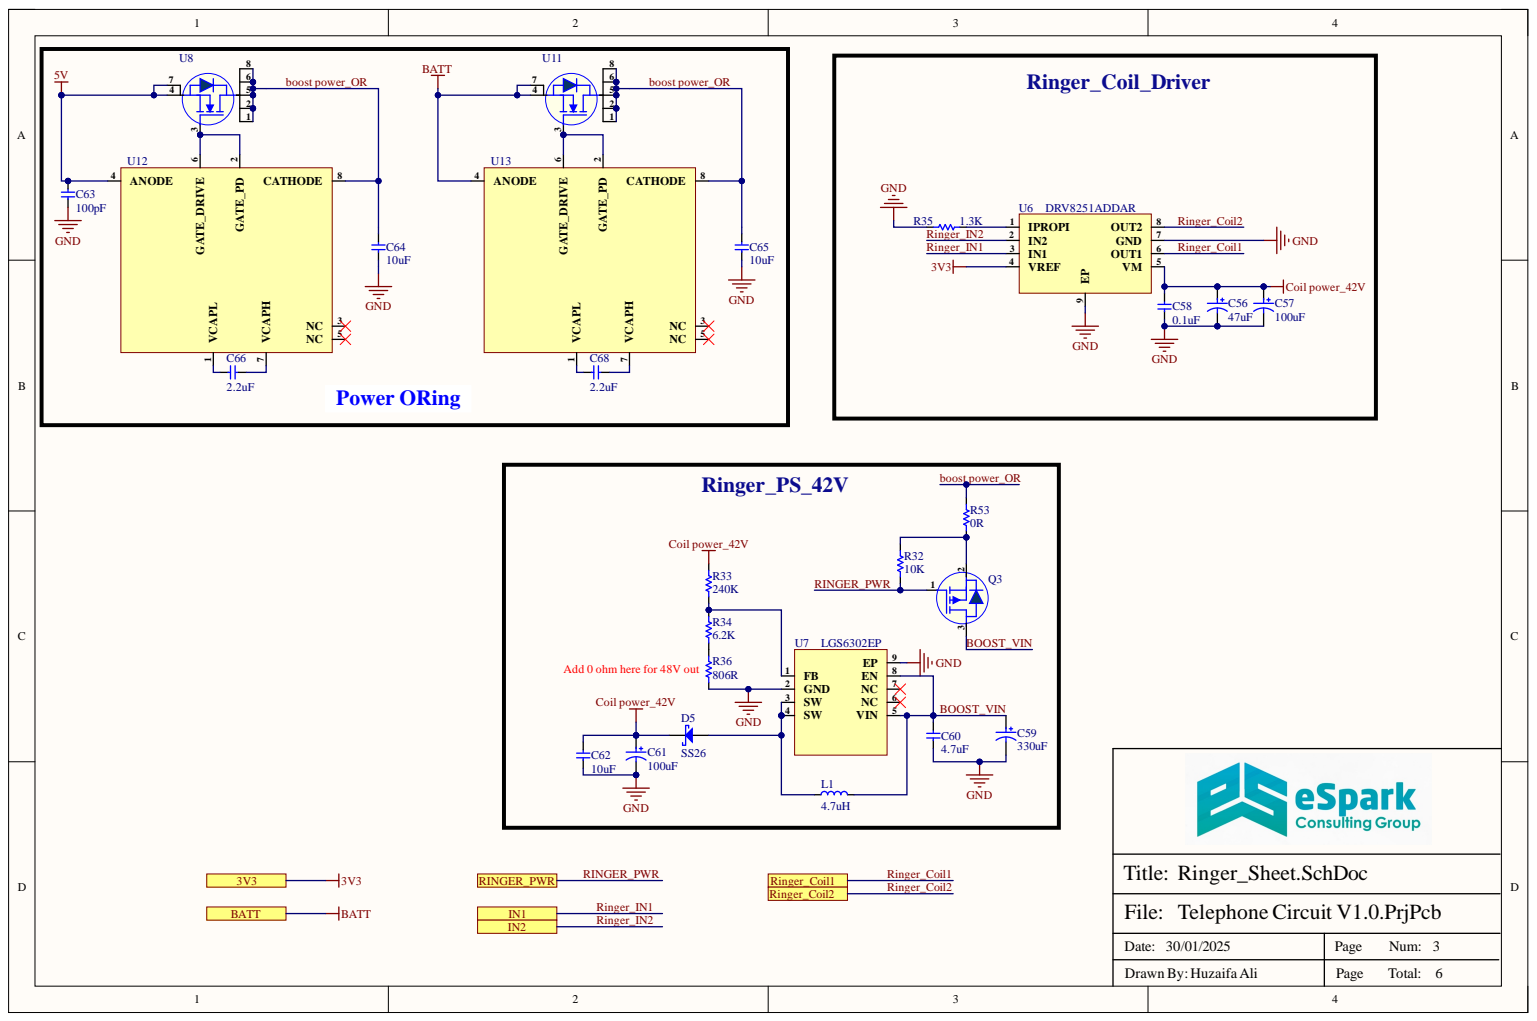
[picture p16: page 3]

806R Add 0 ohm here for 48V out

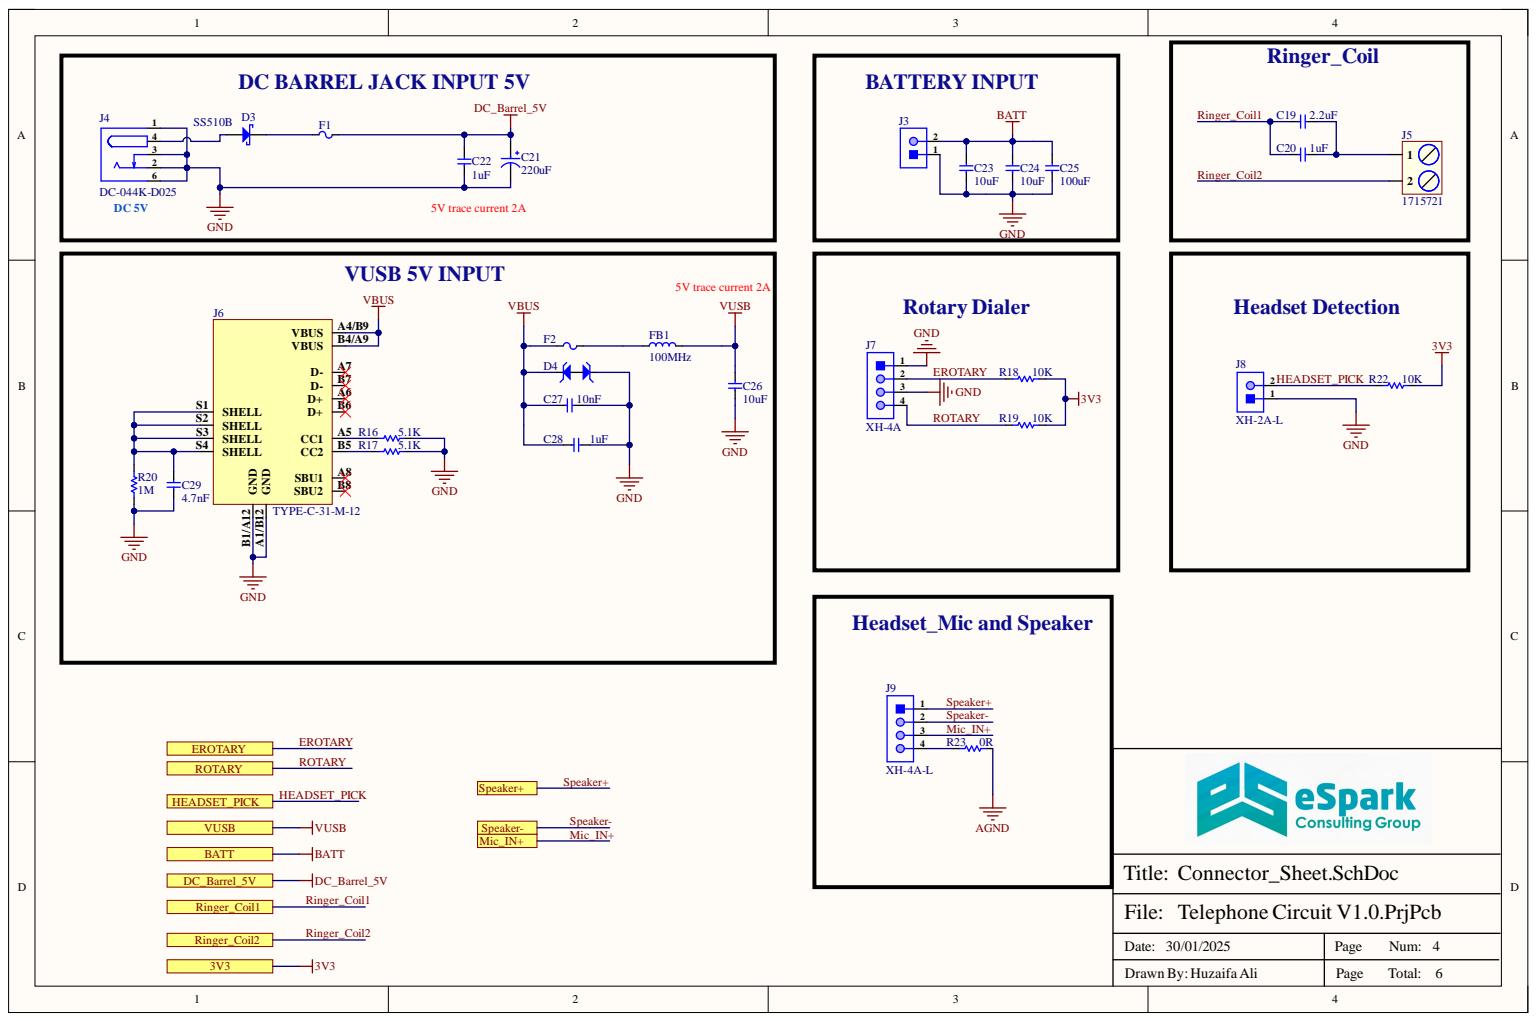
[picture p17: page 4]

DC BARREL JACK INPUT 5V

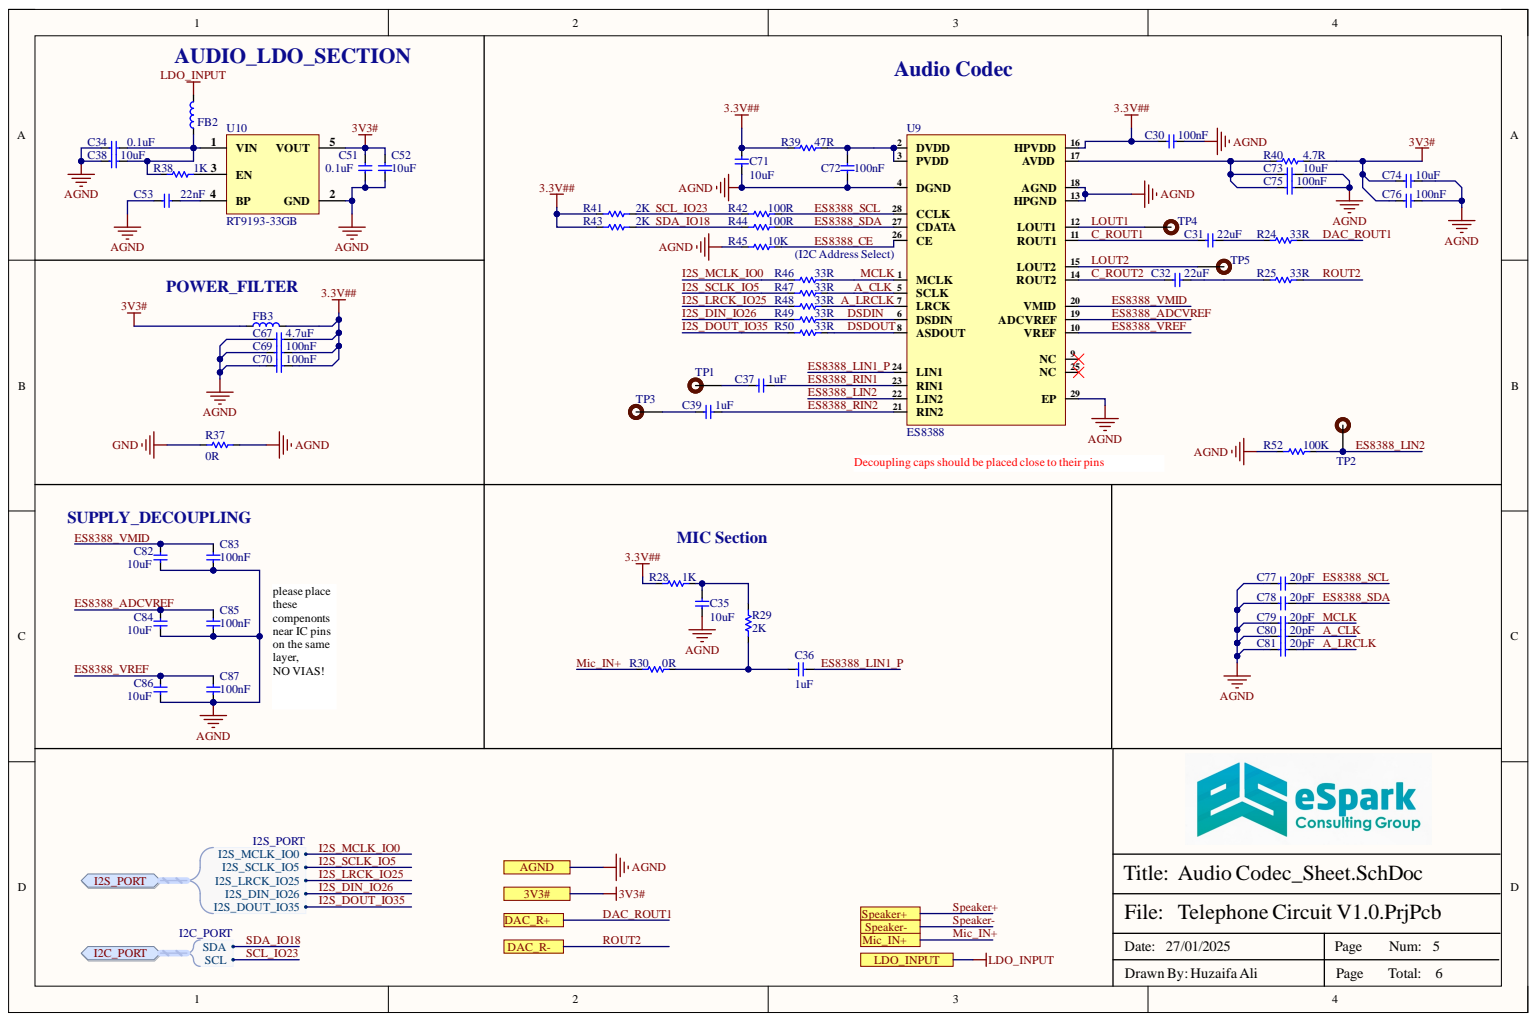
[picture p18: page 5]

Decoupling caps should be placed close to their pins

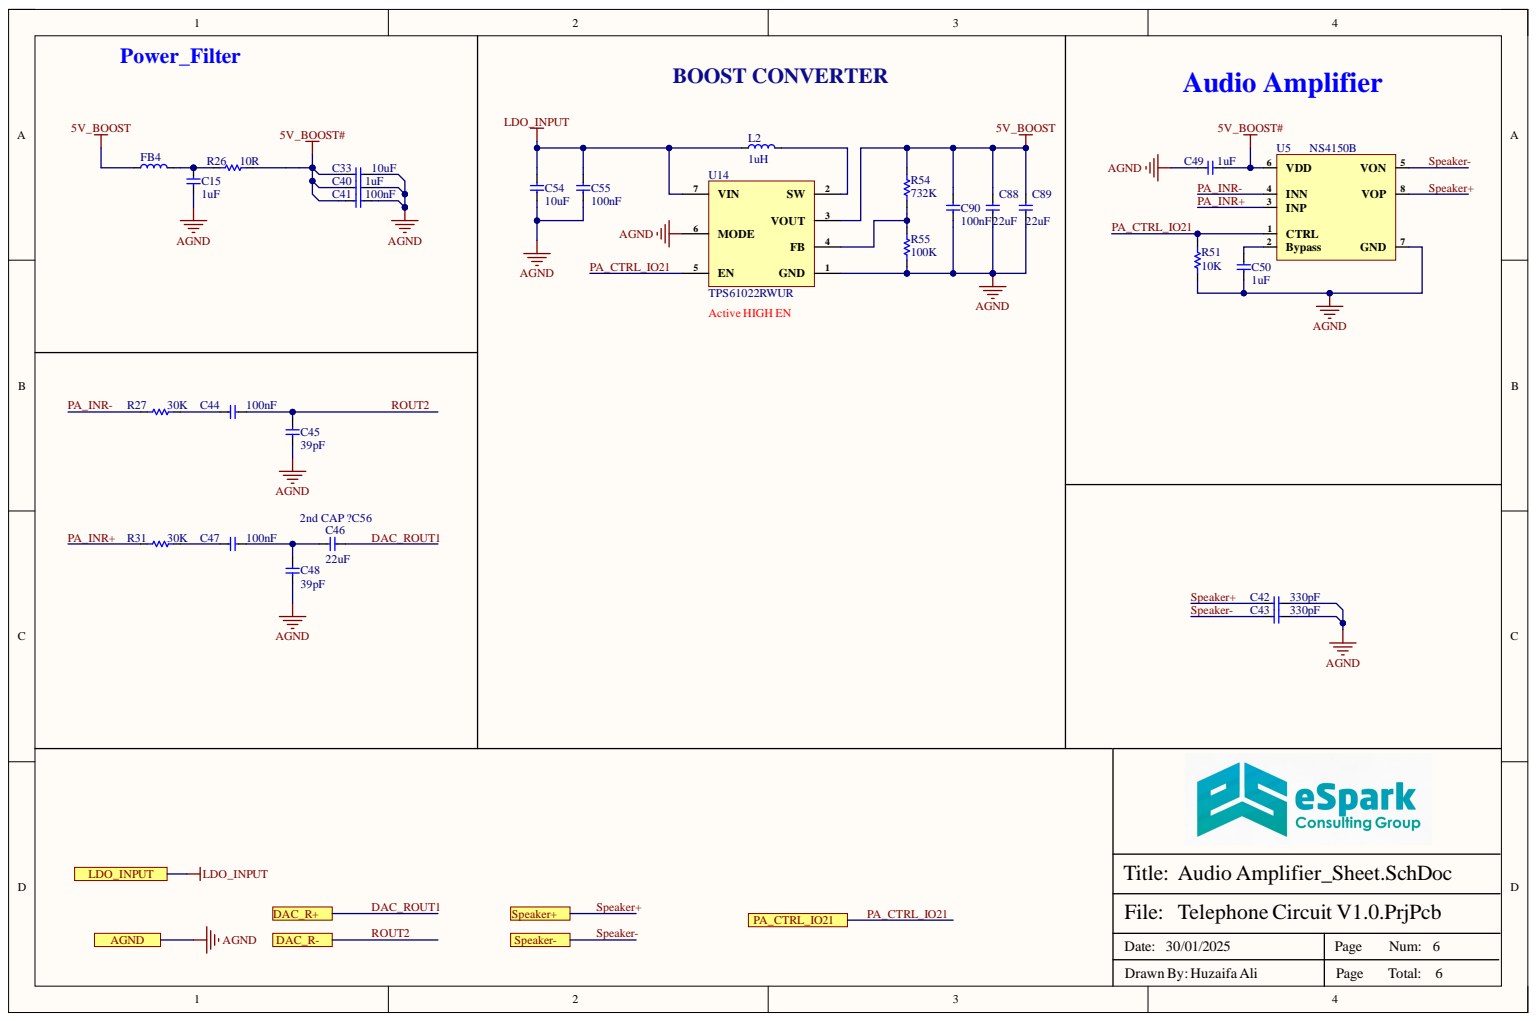
[picture p19: page 6]

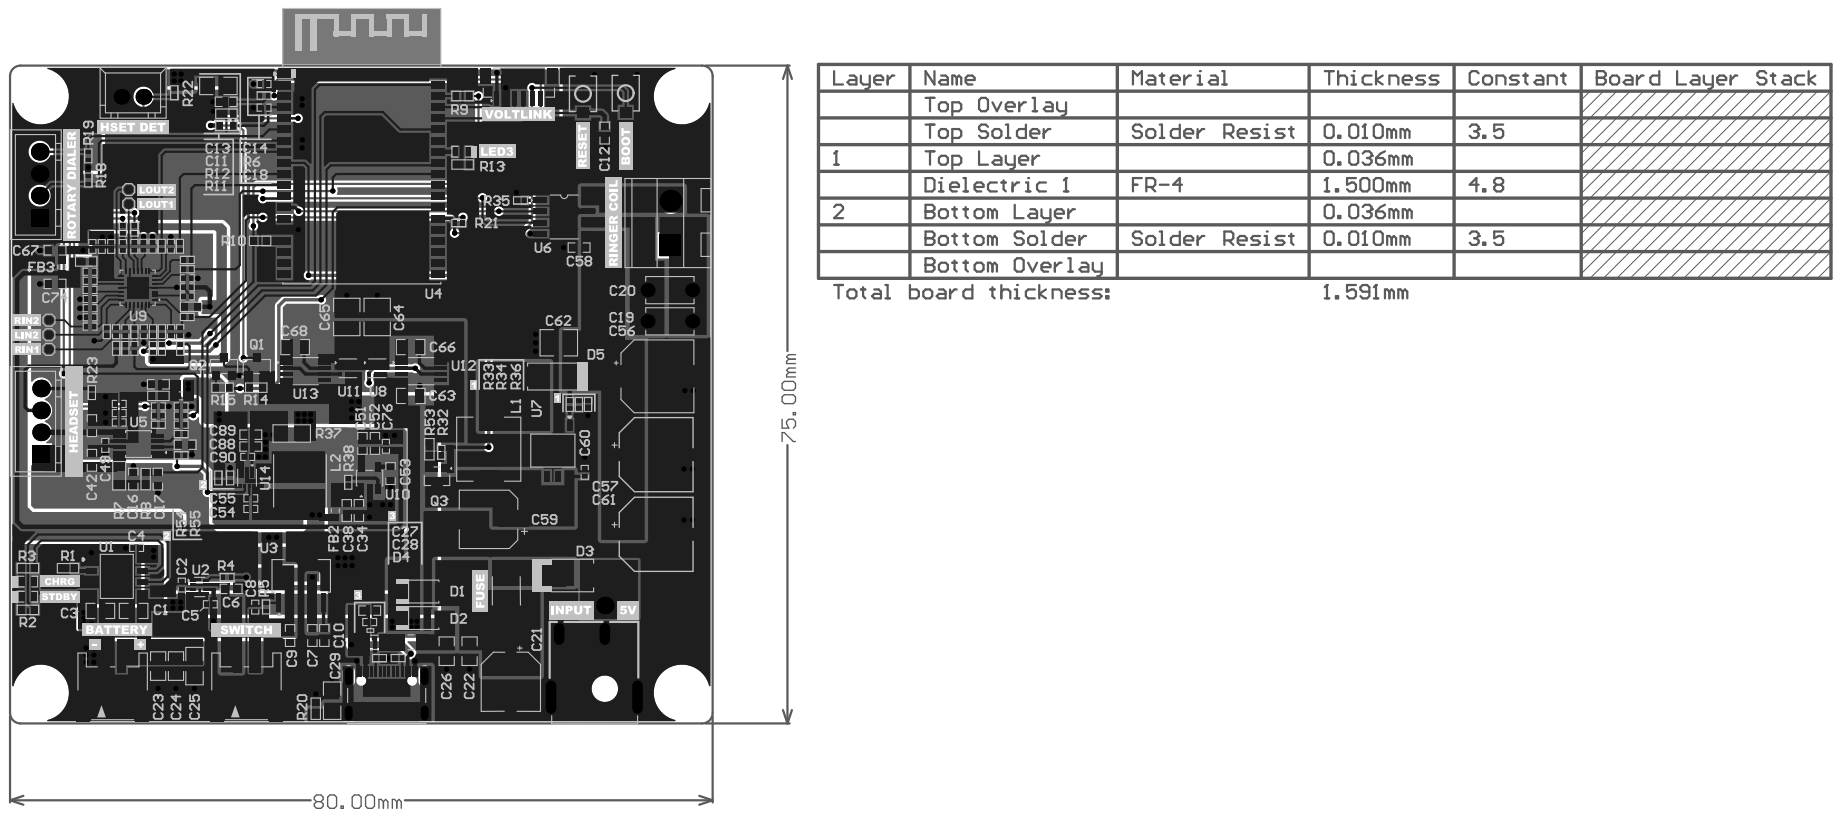
[picture p20: page 7]
