eSpark-Backup/jordanfishman-telephonecircuit/Design-Files/TelephoneCircuit-v1.0/Deliverables/Assembly Drawings/Assembly Drawing.pdf

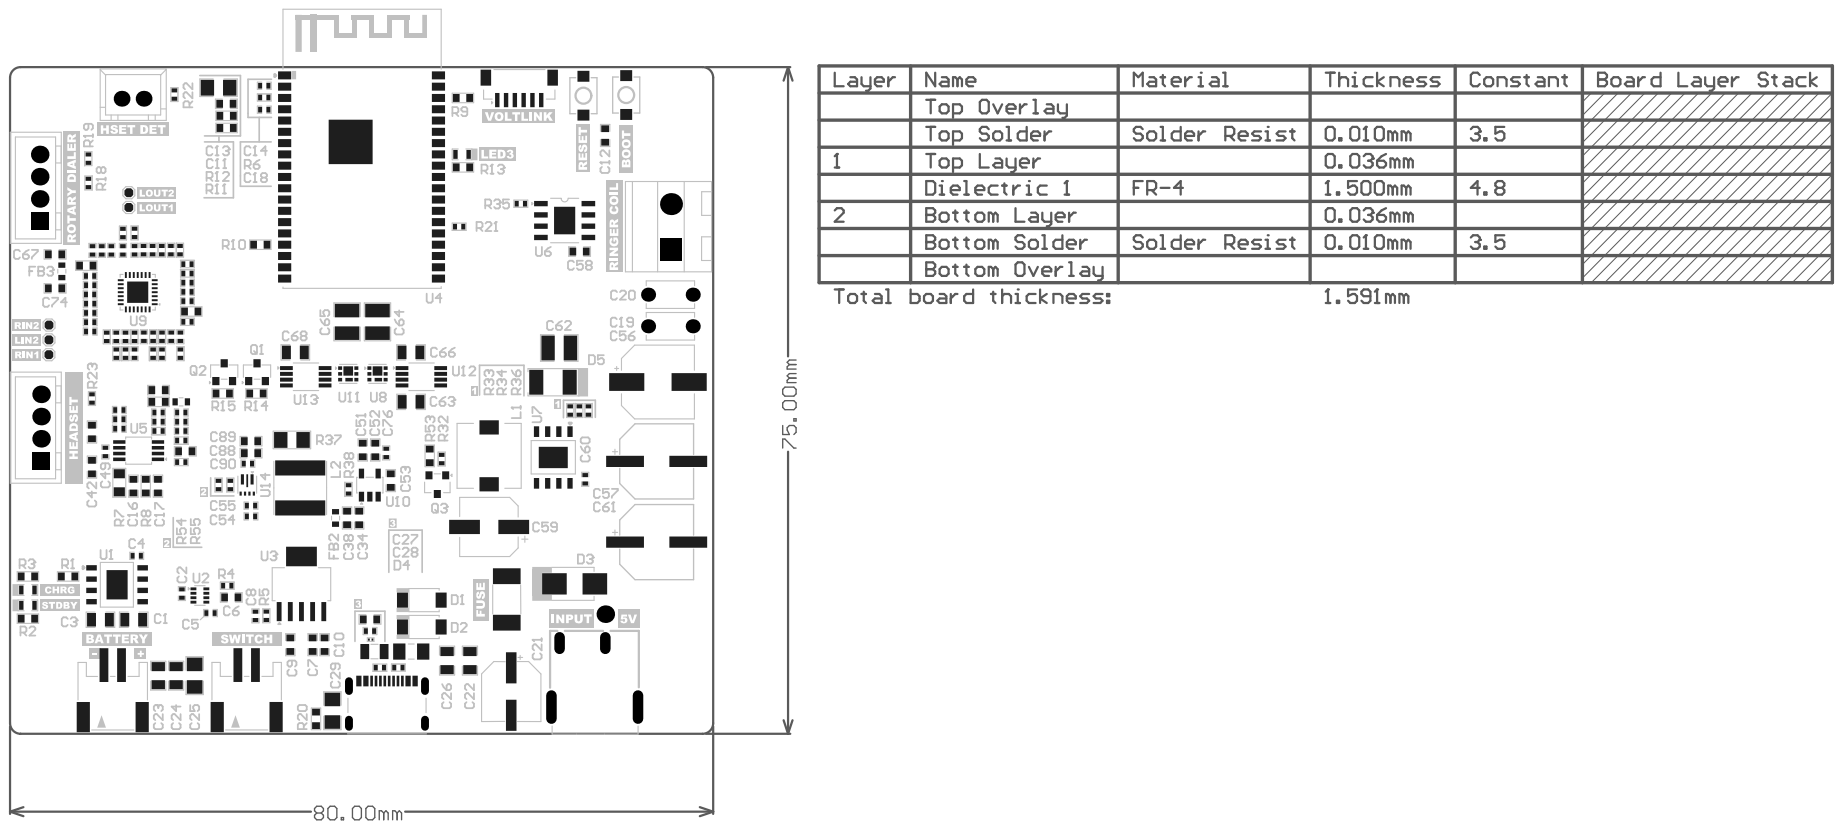
[picture p21: page 1]

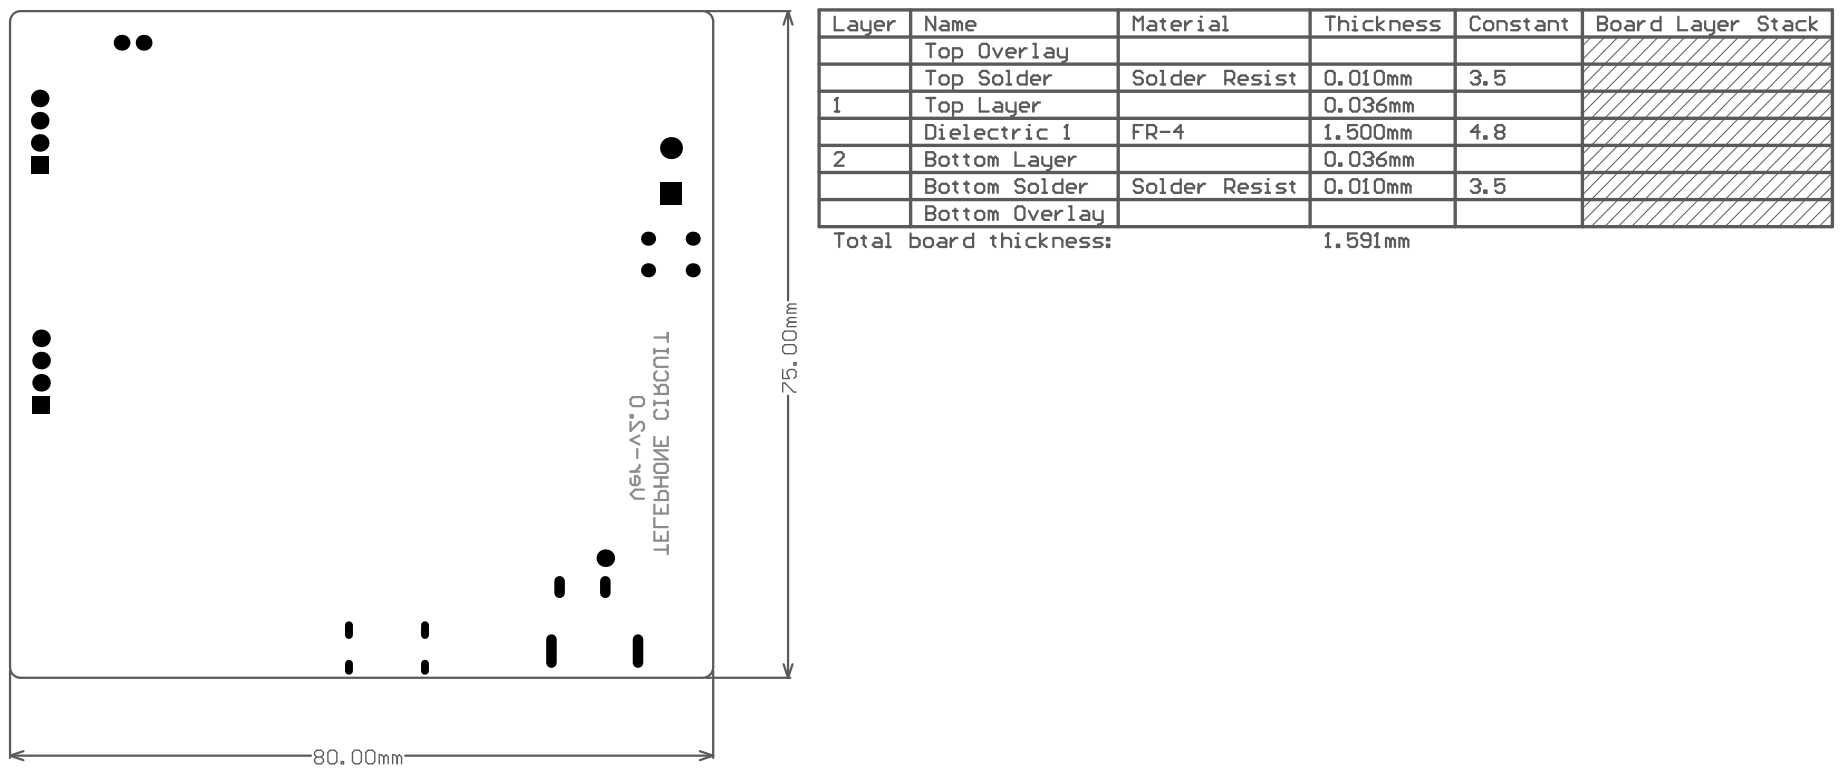
[picture p22: page 2]
