eSpark-Backup/jordanfishman-telephonecircuit/(list of files, drawings)

Other design files:
Design Files/TelephoneCircuit/Speaker-Circuit.PrjPcb
Design-Files/TelephoneCircuit-v1.0/Audio Amplifier_Sheet.SchDoc
Design-Files/TelephoneCircuit-v1.0/Audio Codec_Sheet.SchDoc
Design-Files/TelephoneCircuit-v1.0/Connector_Sheet.SchDoc
Design-Files/TelephoneCircuit-v1.0/Controller_Sheet.SchDoc
Design-Files/TelephoneCircuit-v1.0/Power_Sheet.SchDoc
Design-Files/TelephoneCircuit-v1.0/Ringer_Sheet.SchDoc
Design-Files/TelephoneCircuit-v1.0/Telephone Circuit v1.0.PcbDoc
Design-Files/TelephoneCircuit-v1.0/Telephone Circuit V1.0.PrjPcb
