eSpark-Backup/jordanfishman-telephonecircuit/(commit log)

2024-12-19 #1 Added basic implementation scheme
    [Connector_Sheet.SchDoc, Controller_Sheet.SchDoc, Power_Sheet.SchDoc, Speaker-Circuit.PrjPcb]
2024-12-20 #1 updated controller section (in progress)
    [Controller_Sheet.SchDoc]
2024-12-23 #1 updated power,controller , connector and audio section (in progress)
    [Audio Processing_Sheet.SchDoc, Connector_Sheet.SchDoc, Controller_Sheet.SchDoc, Power_Sheet.SchDoc, Telephone Circuit V1.0.PrjPcb]
2024-12-24 #1 updated ringer section and power sheet and audio section (in progress)
    [Audio Processing_Sheet.SchDoc, Connector_Sheet.SchDoc, Power_Sheet.SchDoc, Ringer_Sheet.SchDoc, Telephone Circuit V1.0.PrjPcb]
2024-12-26 #1 Updated Power Sheet, Controller , ringer , connector sheets (in progress)
    [Audio Processing_Sheet.SchDoc, Connector_Sheet.SchDoc, Controller_Sheet.SchDoc, Power_Sheet.SchDoc, Ringer_Sheet.SchDoc, Telephone Circuit V1.0.PrjPcb]
2024-12-27 #1 Added git ignore file changes pushed
    [Connector_Sheet.SchDoc, Controller_Sheet.SchDoc, Ringer_Sheet.SchDoc]
2024-12-27 # Updated Schematic (in progress)
    [Audio Codec_Sheet.SchDoc, Audio Processing_Sheet.SchDoc, Connector_Sheet.SchDoc, Controller_Sheet.SchDoc, Power_Sheet.SchDoc, Ringer_Sheet.SchDoc, Telephone Circuit V1.0.PrjPcb]
2024-12-30 #1 Schematic changes done
    [Audio Amplifier_Sheet.SchDoc, Audio Codec_Sheet.SchDoc, Connector_Sheet.SchDoc, Controller_Sheet.SchDoc, Power_Sheet.SchDoc, Ringer_Sheet.SchDoc, Telephone Circuit V1.0.PrjPcb]
2025-01-01 #2 updated schematic based upon recomendations
    [Audio Amplifier_Sheet.SchDoc, Audio Codec_Sheet.SchDoc, Controller_Sheet.SchDoc, Ringer_Sheet.SchDoc]
2025-01-01 #2 updated Amplifier section (done)
    [Audio Amplifier_Sheet.SchDoc, Ringer_Sheet.SchDoc]
2025-01-02 #2 UPdated Amplifier Section
    [Audio Amplifier_Sheet.SchDoc]
2025-01-03 #2 Updated J6 and c23 and c24 library sources
    [Connector_Sheet.SchDoc, Controller_Sheet.SchDoc, Power_Sheet.SchDoc, Telephone Circuit V1.0.PrjPcb]
2025-01-06 #3 Placement InProgress.
    [Ringer_Sheet.SchDoc, Telephone Circuit V1.0.PrjPcb, Telephone Circuit v1.0.PcbDoc]
2025-01-07 #3 Updated Files.
    [Audio Amplifier_Sheet.SchDoc, Audio Codec_Sheet.SchDoc, Controller_Sheet.SchDoc, Telephone Circuit v1.0.PcbDoc]
2025-01-08 #3 Updated Files
    [Audio Amplifier_Sheet.SchDoc, Audio Codec_Sheet.SchDoc, Telephone Circuit v1.0.PcbDoc]
2025-01-20 #2 Changed C13 capacitor , swapped Controller pins
    [Audio Amplifier_Sheet.SchDoc, Controller_Sheet.SchDoc, Telephone Circuit V1.0.PrjPcb]
2025-01-20 #3 Routing in Progress
    [Telephone Circuit v1.0.PcbDoc]
2025-01-21 #3 Swapped ERotary and I2S DOUT IO35 for PCB routing
    [Controller_Sheet.SchDoc]
2025-01-21 #3 Routing In progress.
    [Telephone Circuit v1.0.PcbDoc]
2025-01-24 #3 Routing Completed.
    [Telephone Circuit v1.0.PcbDoc]
2025-01-30 #3 Updated BOOT and RESET buttons (done )
    [Audio Amplifier_Sheet.SchDoc, Connector_Sheet.SchDoc, Controller_Sheet.SchDoc, Ringer_Sheet.SchDoc]
2025-01-31 #4 Modification in Progress
    [Telephone Circuit V1.0.PrjPcb, Telephone Circuit v1.0.PcbDoc]
2025-02-03 #4 Review and Modification Completed & Deliverables Generated
    [Centroid File.csv, Pick Place for Telephone Circuit v1.0.csv, Telephone Circuit V1.0.PrjPcb, Telephone Circuit v1.0.DWG, Telephone Circuit v1.0.DXF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]
2025-02-12 #5 Client and JLCPCB BOM added.
    [Client-BOM-V1.0.xlsx, JLCPCB-BOM-V1.0.xlsx]
2025-03-17 Add: Version number
    [Audio Amplifier_Sheet.SchDoc, Audio Codec_Sheet.SchDoc, Centroid File.csv, Client-BOM-V1.0.xlsx, Connector_Sheet.SchDoc, Controller_Sheet.SchDoc, JLCPCB-BOM-V1.0.xlsx, Pick Place for Telephone Circuit v1.0.csv]
